mbelanger0/nixie-tube-clock/Eclectronics/3dshapes/DFN1006-2.stp

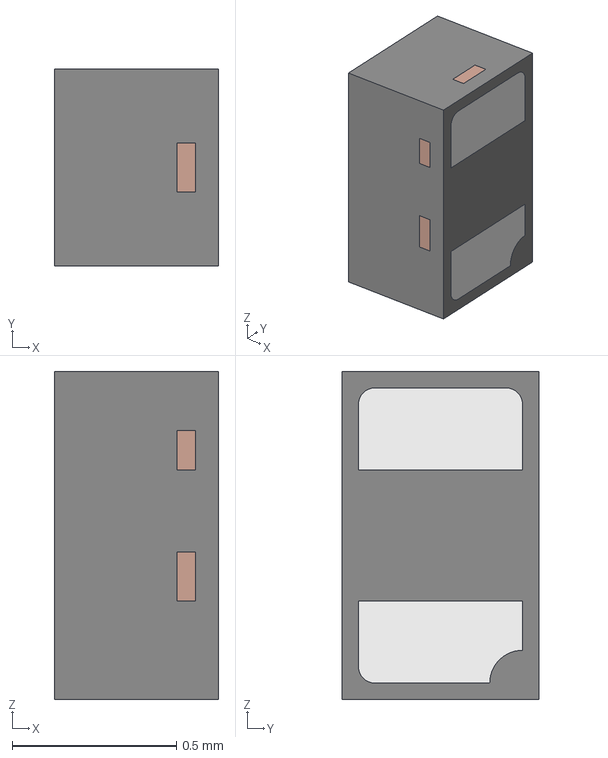
[picture p2: CAD file, 2026-03-12]
Eclectronics/3dshapes/DFN1006-2.stp
0.5 x 0.6 x 1.00 mm
LDF
