mbelanger0/nixie-tube-clock/eclectronics_nixie_3dmodels/c-1825027-8-g-3d.stp

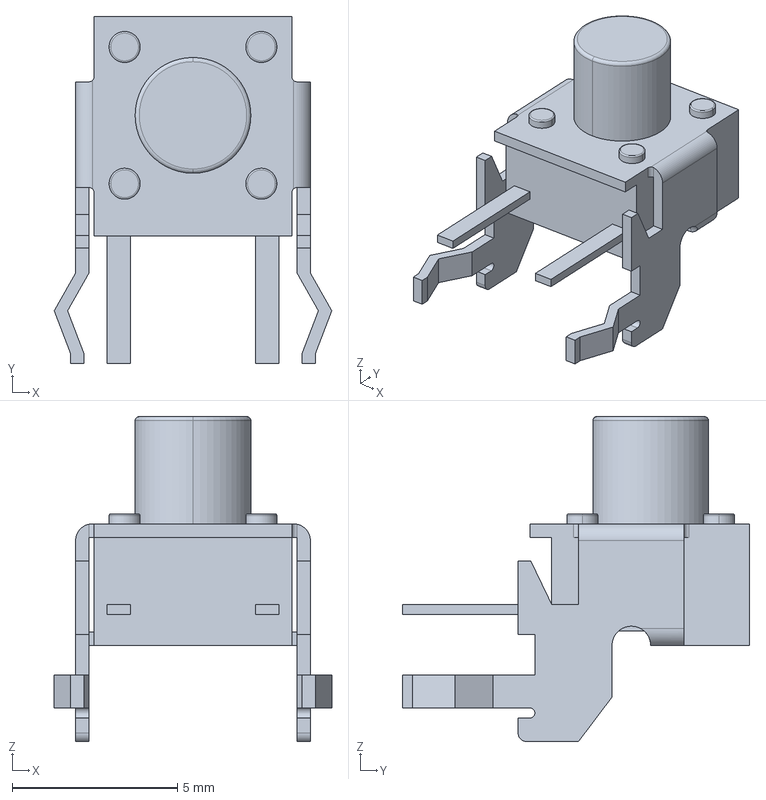
[picture p3: CAD file, 2026-04-13]
eclectronics_nixie_3dmodels/c-1825027-8-g-3d.stp
8.41 x 10.5 x 9.84 mm
