mbelanger0/nixie-tube-clock/Eclectronics/3dshapes/QFN-32_5x5.stp

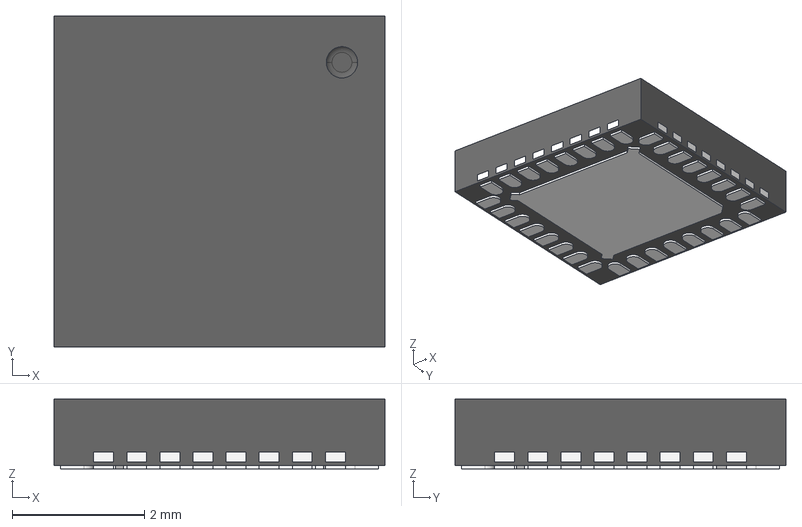
[picture p4: CAD file, 2026-03-12]
Eclectronics/3dshapes/QFN-32_5x5.stp
5.00 x 5.00 x 1.05 mm
