mbelanger0/nixie-tube-clock/eclectronics_nixie_3dmodels/Download_WE-PD_1210_STP+%28rev1%29.stp

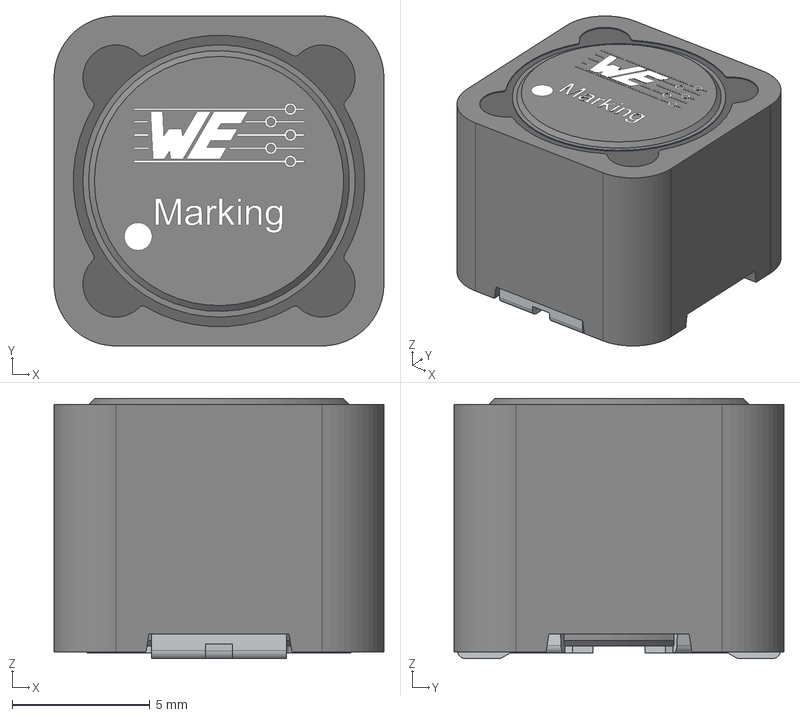
[picture p5: CAD file, 2026-04-06]
eclectronics_nixie_3dmodels/Download_WE-PD_1210_STP+%28rev1%29.stp
12.0 x 12.0 x 9.46 mm
Core
ShieldRing
Glue
Leadframe
