mbelanger0/nixie-tube-clock/Eclectronics/3dshapes/WS2812_RGB_LED_updated.stp

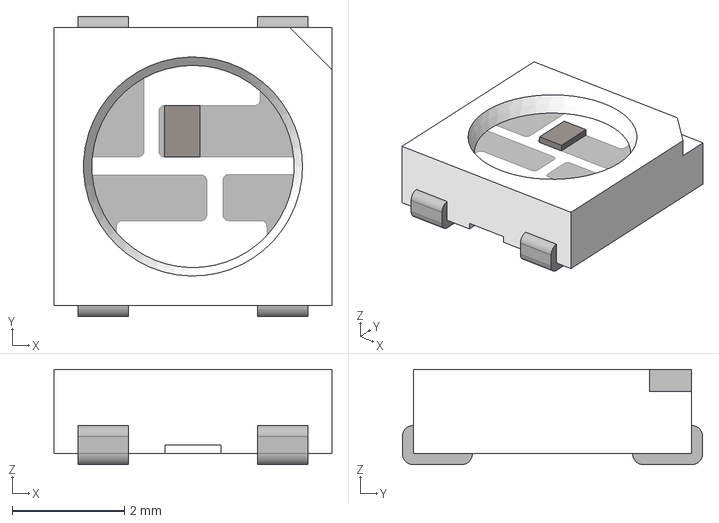
[picture p6: CAD file, 2026-03-12]
Eclectronics/3dshapes/WS2812_RGB_LED_updated.stp
4.95 x 5.35 x 1.70 mm
