mbelanger0/nixie-tube-clock/eclectronics_nixie_3dmodels/UCC3803DTR.stp

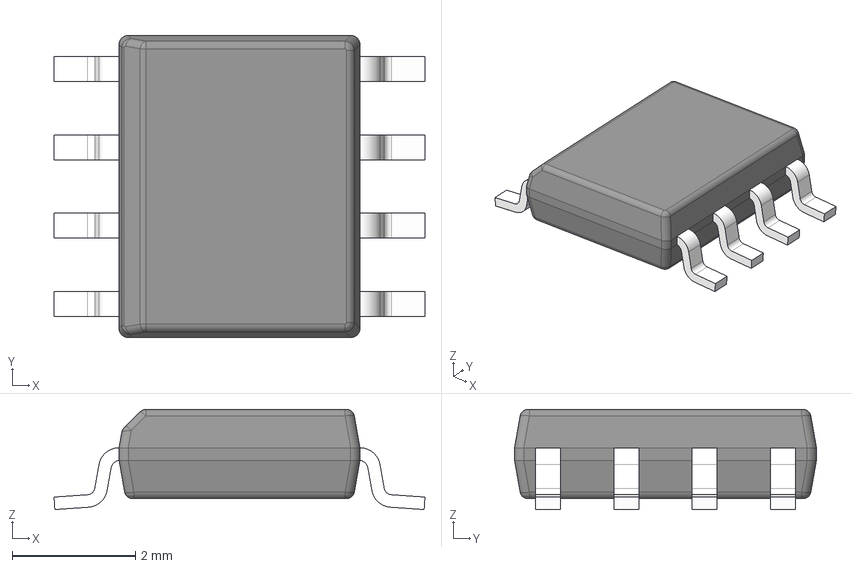
[picture p7: CAD file, 2026-04-02]
eclectronics_nixie_3dmodels/UCC3803DTR.stp
6.02 x 4.90 x 1.63 mm
BODY-SO
LEAD-D0008A x 8
