mbelanger0/nixie-tube-clock/Eclectronics/3dshapes/UFQFPN48.stp

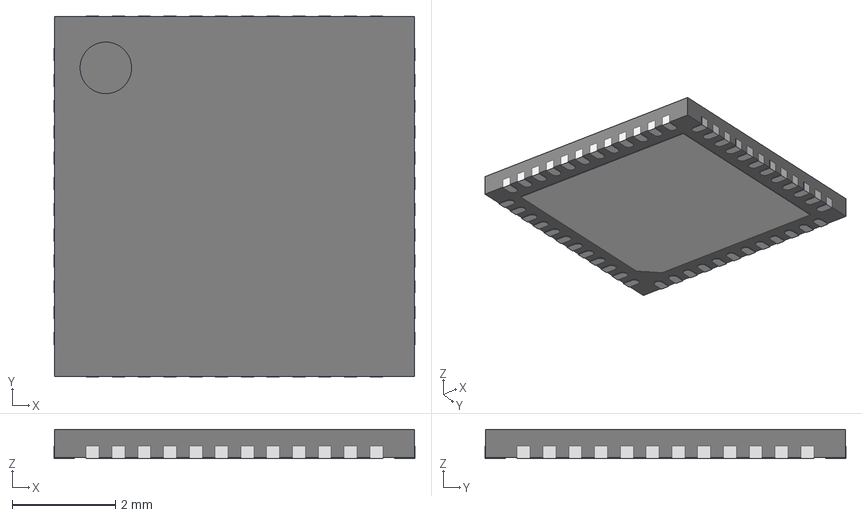
[picture p8: CAD file, 2026-03-12]
Eclectronics/3dshapes/UFQFPN48.stp
7.00 x 7.00 x 0.57 mm
