mbelanger0/nixie-tube-clock/Eclectronics/3dshapes/Analog_Devices_Inc_-_ADXL362BCCZ.step

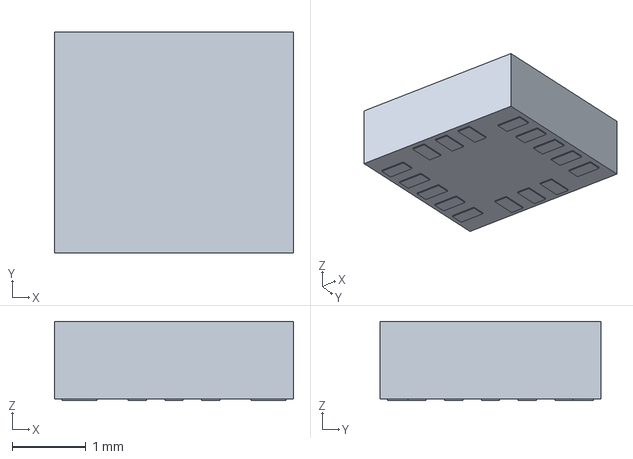
[picture p9: CAD file, 2026-03-12]
Eclectronics/3dshapes/Analog_Devices_Inc_-_ADXL362BCCZ.step
3.25 x 3.00 x 1.08 mm
