mbelanger0/nixie-tube-clock/eclectronics_nixie_3dmodels/QFP44_10x10MC_MCH.step

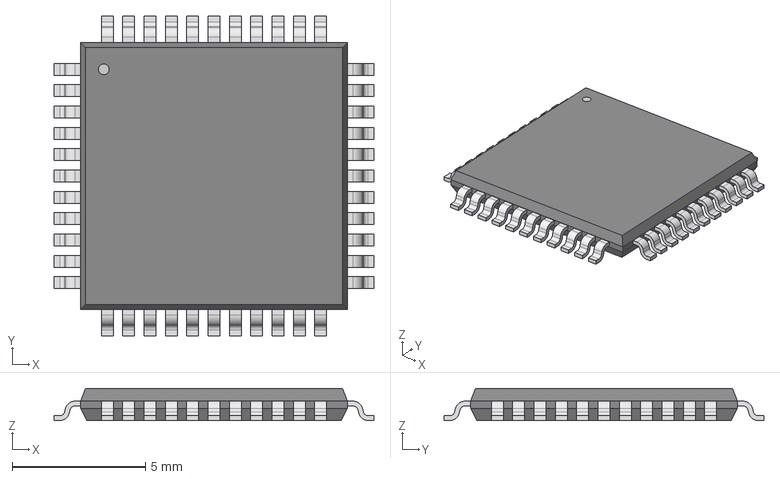
[picture p10: CAD file, 2026-03-23]
eclectronics_nixie_3dmodels/QFP44_10x10MC_MCH.step
12.0 x 12.0 x 1.20 mm
