mbelanger0/nixie-tube-clock/Eclectronics/3dshapes/TL3301NFxxxxJ.stp

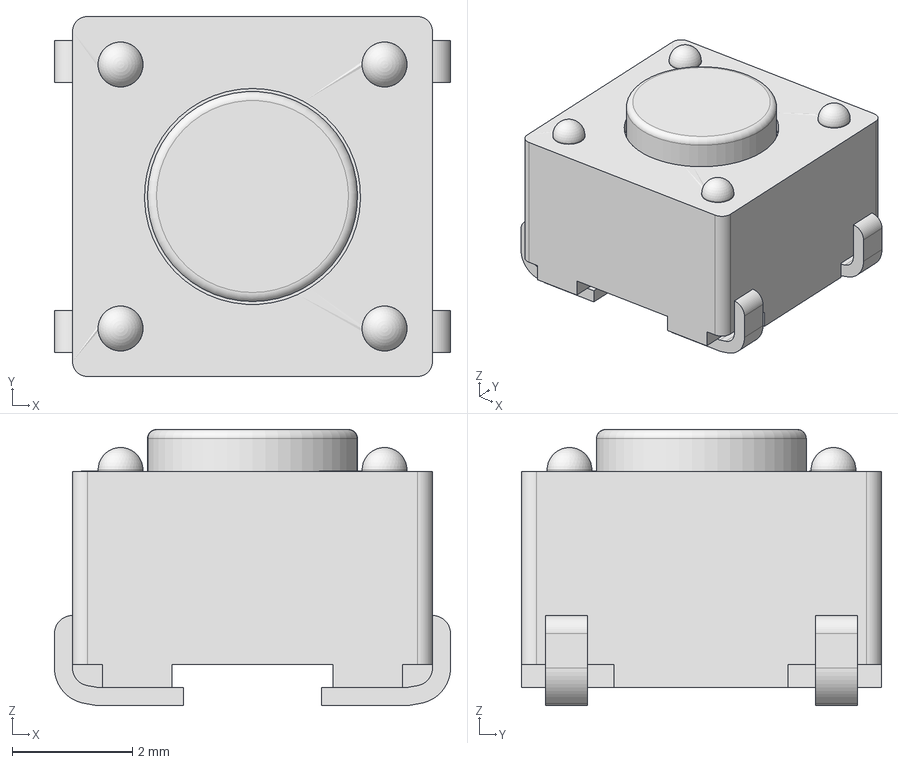
[picture p11: CAD file, 2026-03-12]
Eclectronics/3dshapes/TL3301NFxxxxJ.stp
6.60 x 6.00 x 4.60 mm
