mbelanger0/nixie-tube-clock/Eclectronics/3dshapes/CUI_DEVICES_PJ-202A.step

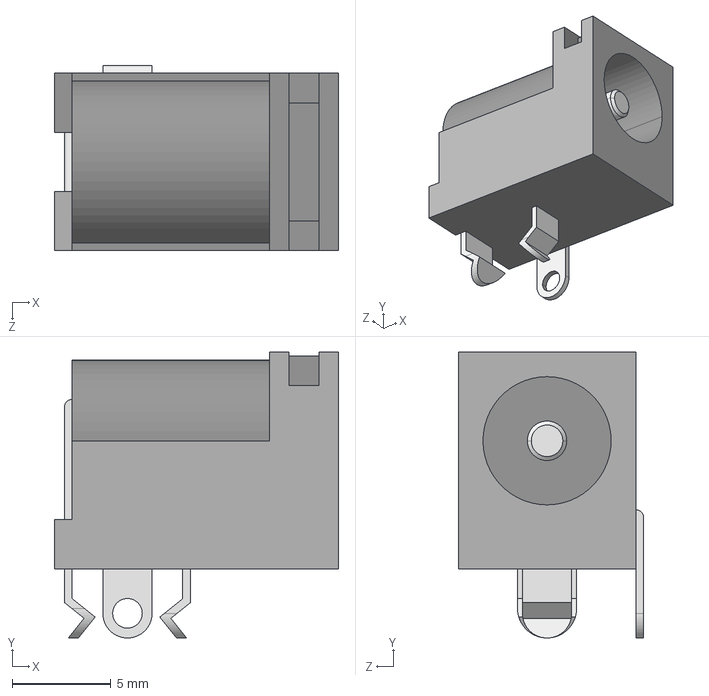
[picture p12: CAD file, 2026-03-12]
Eclectronics/3dshapes/CUI_DEVICES_PJ-202A.step
14.4 x 14.5 x 9.40 mm
