mbelanger0/nixie-tube-clock/Eclectronics/3dshapes/CUI_SDS-50J.step

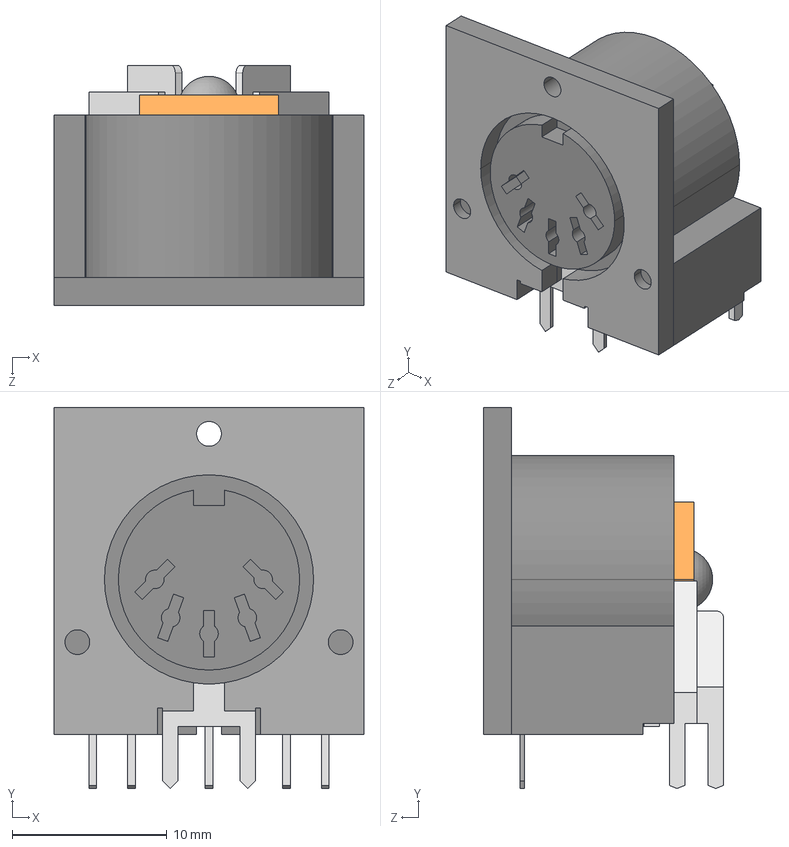
[picture p13: CAD file, 2026-03-12]
Eclectronics/3dshapes/CUI_SDS-50J.step
20.0 x 24.6 x 15.5 mm
