mbelanger0/nixie-tube-clock/Eclectronics/3dshapes/DFN8_3x3_0.65.step

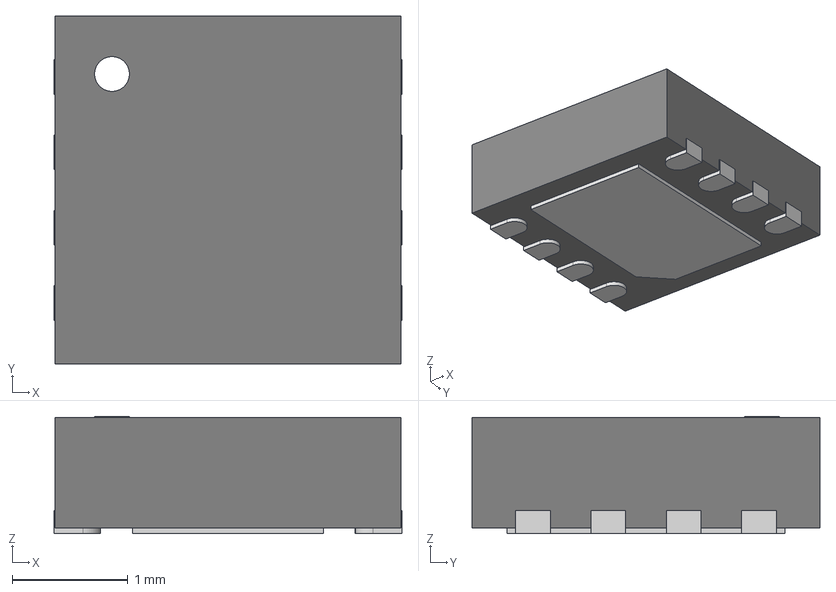
[picture p14: CAD file, 2026-03-12]
Eclectronics/3dshapes/DFN8_3x3_0.65.step
3.00 x 3.00 x 1.01 mm
