mbelanger0/nixie-tube-clock/Eclectronics/3dshapes/RP2350A-QFN60.step

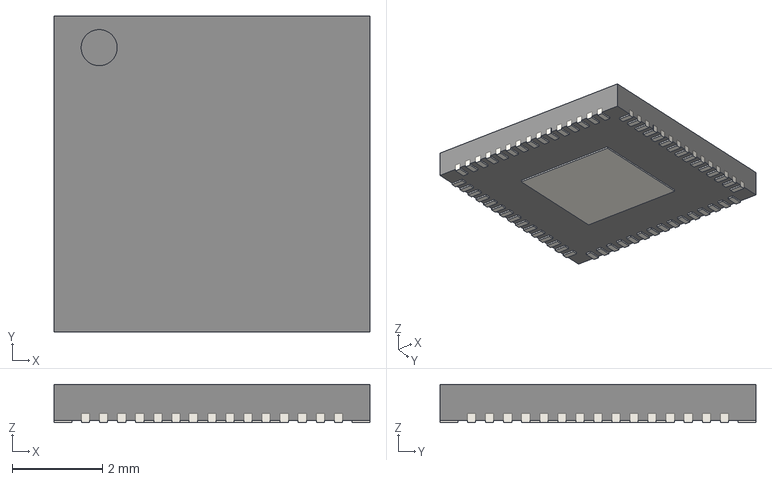
[picture p15: CAD file, 2026-03-12]
Eclectronics/3dshapes/RP2350A-QFN60.step
7.00 x 7.00 x 0.85 mm
