mbelanger0/nixie-tube-clock/Eclectronics/3dshapes/BarrelJack.STEP

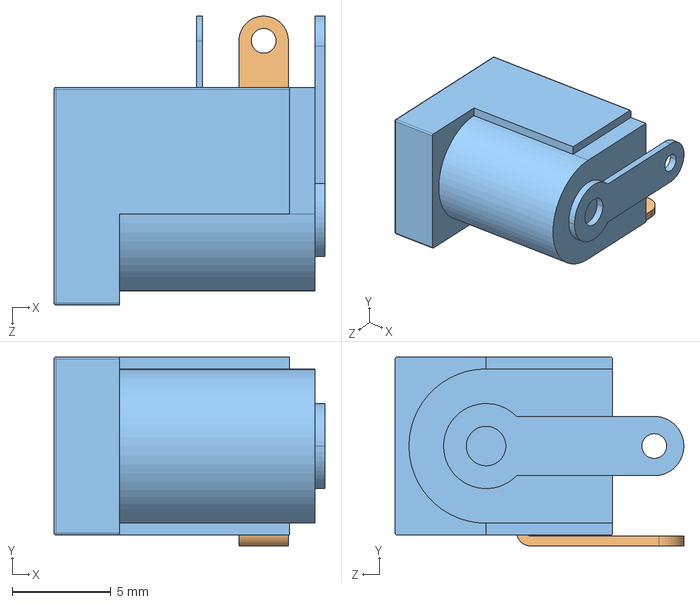
[picture p16: CAD file, 2026-03-12]
Eclectronics/3dshapes/BarrelJack.STEP
13.7 x 9.55 x 14.6 mm
