mbelanger0/nixie-tube-clock/Eclectronics/3dshapes/WSON8-6x5.STEP

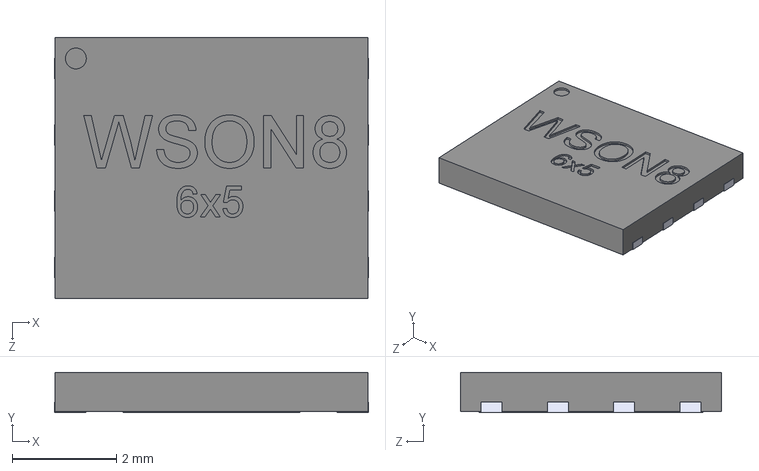
[picture p17: CAD file, 2026-03-12]
Eclectronics/3dshapes/WSON8-6x5.STEP
6.02 x 0.77 x 5.00 mm
