mbelanger0/nixie-tube-clock/Eclectronics/3dshapes/RP2040_QFN_PACKAGE.STEP

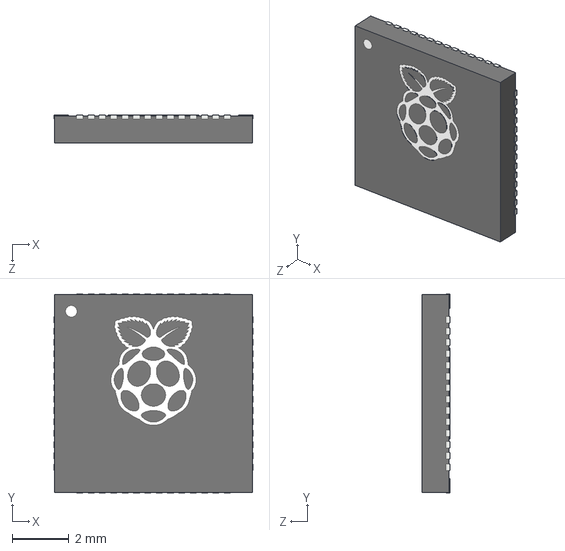
[picture p18: CAD file, 2026-03-12]
Eclectronics/3dshapes/RP2040_QFN_PACKAGE.STEP
7.02 x 7.02 x 1.00 mm
