mbelanger0/nixie-tube-clock/Eclectronics/3dshapes/ABM10.STP

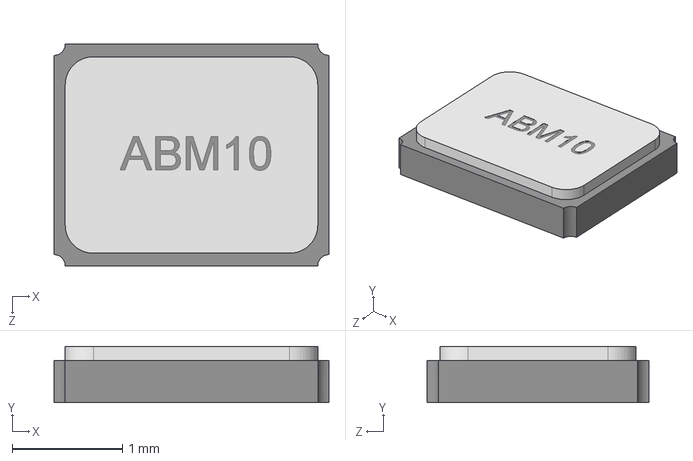
[picture p19: CAD file, 2026-03-12]
Eclectronics/3dshapes/ABM10.STP
2.49 x 0.508 x 2.01 mm
