mbelanger0/nixie-tube-clock/Eclectronics/3dshapes/EEEFTH101XAL.step

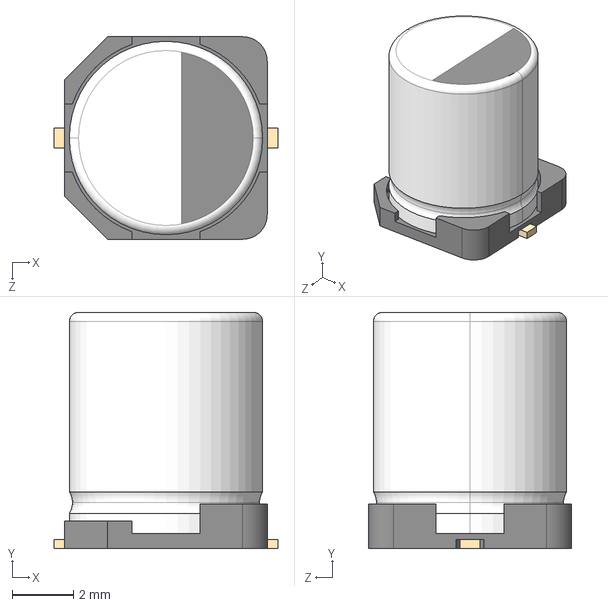
[picture p20: CAD file, 2026-03-12]
Eclectronics/3dshapes/EEEFTH101XAL.step
7.30 x 7.70 x 6.60 mm
