mbelanger0/nixie-tube-clock/Eclectronics/3dshapes/IN-S85TATRGB.stp

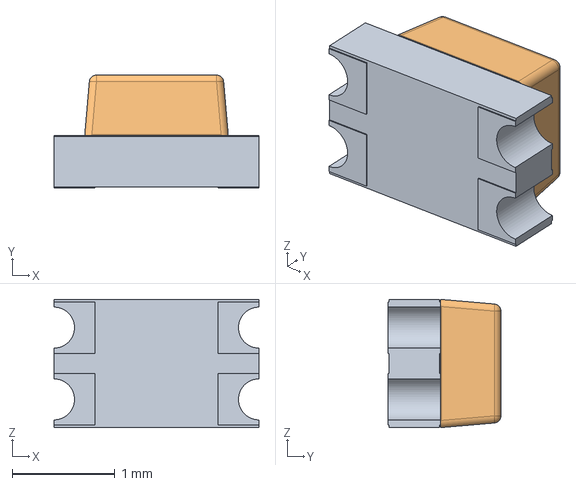
[picture p22: CAD file, 2026-03-12]
Eclectronics/3dshapes/IN-S85TATRGB.stp
2.00 x 1.10 x 1.25 mm
