mbelanger0/nixie-tube-clock/Eclectronics/3dshapes/TL3301AFxxxxJ.stp

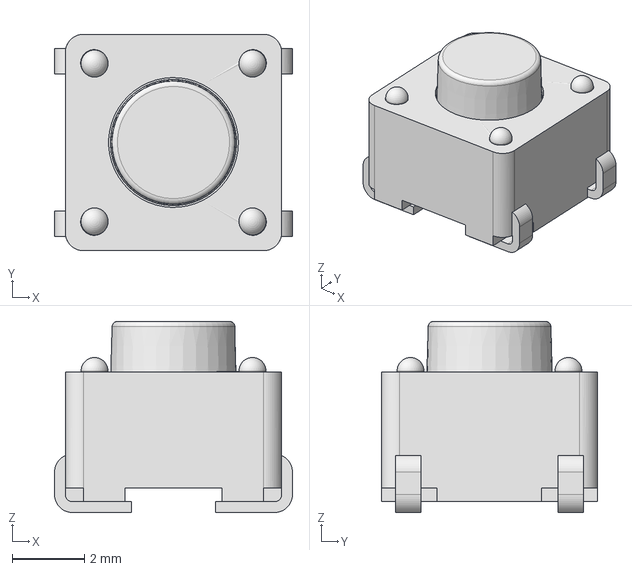
[picture p23: CAD file, 2026-03-12]
Eclectronics/3dshapes/TL3301AFxxxxJ.stp
6.60 x 6.00 x 5.30 mm
