mbelanger0/nixie-tube-clock/Eclectronics/3dshapes/219-3M.STEP

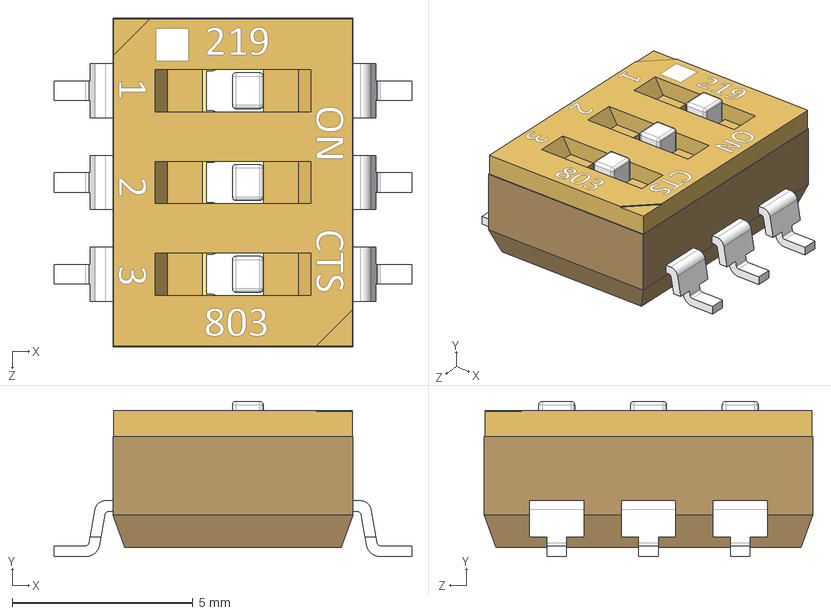
[picture p24: CAD file, 2026-03-12]
Eclectronics/3dshapes/219-3M.STEP
9.91 x 4.30 x 9.10 mm
