mbelanger0/nixie-tube-clock/Eclectronics/3dshapes/KXT321LHS.stp

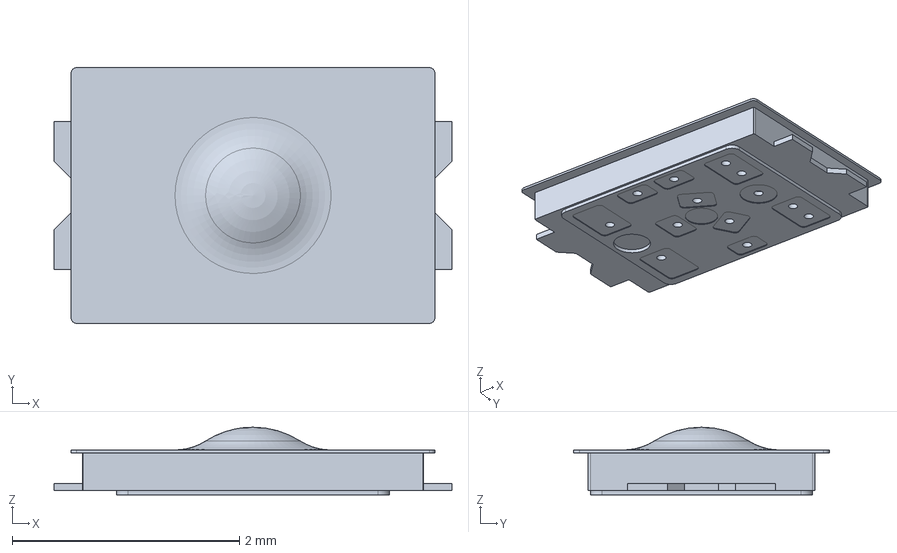
[picture p25: CAD file, 2026-03-12]
Eclectronics/3dshapes/KXT321LHS.stp
3.50 x 2.25 x 0.595 mm
