mbelanger0/nixie-tube-clock/Eclectronics/3dshapes/usb4216-03-a.stp

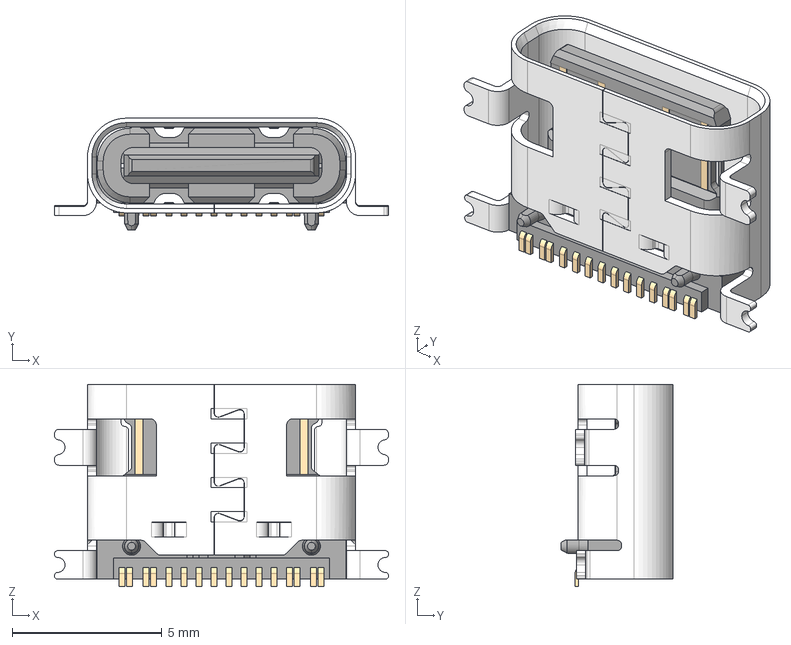
[picture p26: CAD file, 2026-03-12]
Eclectronics/3dshapes/usb4216-03-a.stp
11.1 x 3.73 x 6.75 mm
