mbelanger0/nixie-tube-clock/Eclectronics/3dshapes/AOTA-B201610S3R3-101-T.stp

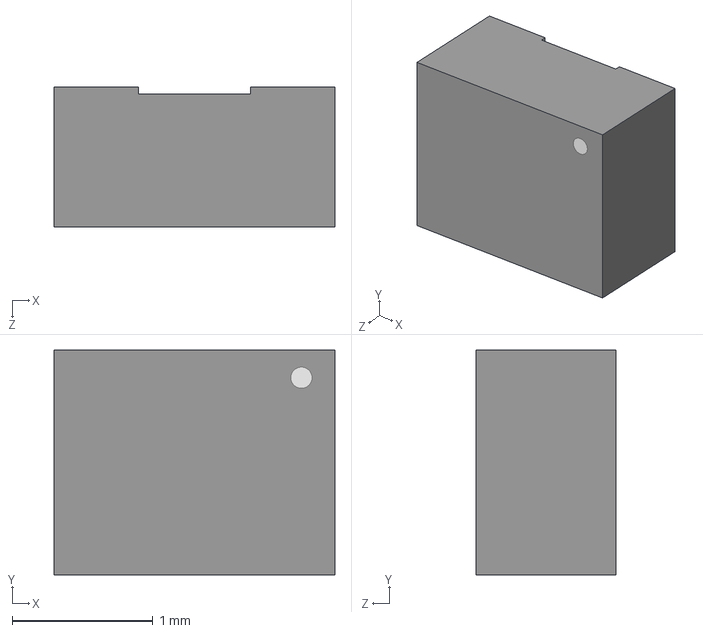
[picture p27: CAD file, 2026-03-12]
Eclectronics/3dshapes/AOTA-B201610S3R3-101-T.stp
2.00 x 1.60 x 1.00 mm
