mbelanger0/nixie-tube-clock/Eclectronics/3dshapes/WS2812-2020.STEP

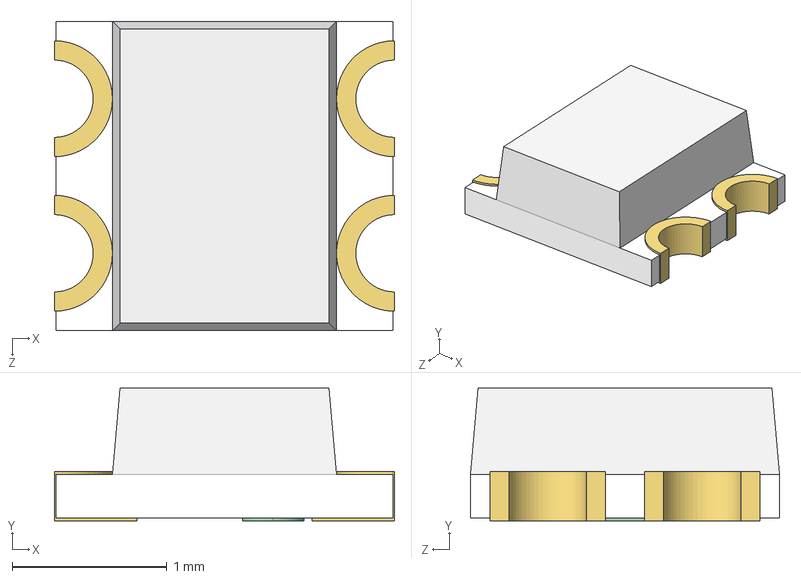
[picture p28: CAD file, 2026-03-12]
Eclectronics/3dshapes/WS2812-2020.STEP
2.20 x 0.86 x 2.00 mm
