mbelanger0/nixie-tube-clock/Eclectronics/3dshapes/USB4505-03-0-A_REVA.step

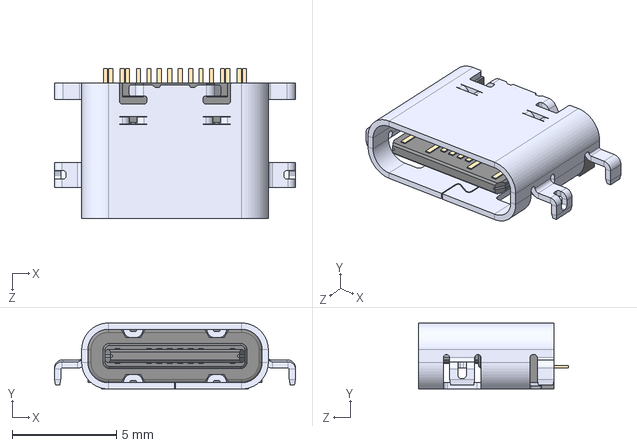
[picture p29: CAD file, 2026-03-12]
Eclectronics/3dshapes/USB4505-03-0-A_REVA.step
11.5 x 3.16 x 7.20 mm
