mbelanger0/nixie-tube-clock/Eclectronics/3dshapes/B4B-XH-A.step

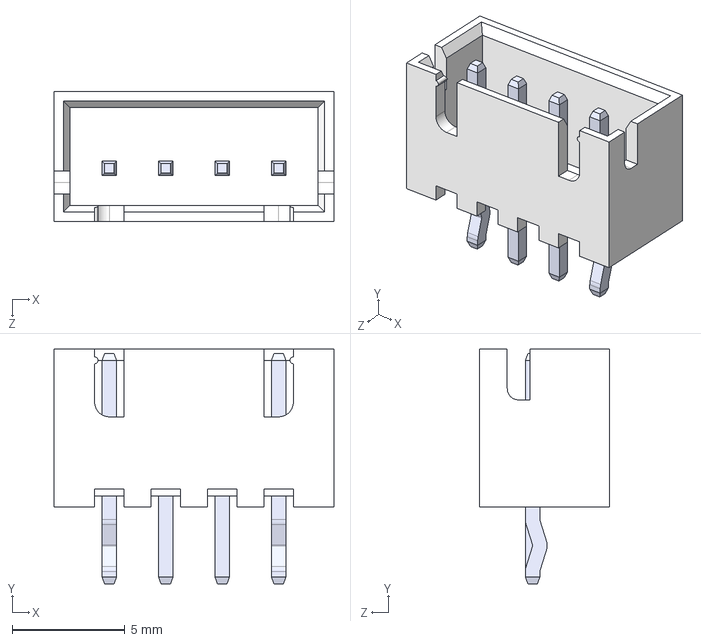
[picture p30: CAD file, 2026-03-12]
Eclectronics/3dshapes/B4B-XH-A.step
12.4 x 10.4 x 5.75 mm
