mbelanger0/nixie-tube-clock/Eclectronics/3dshapes/RTE0020A.stp

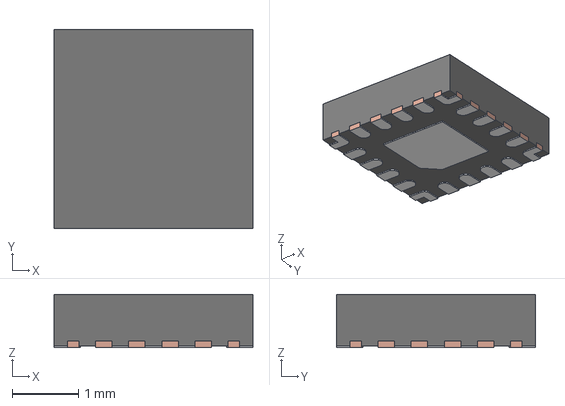
[picture p31: CAD file, 2026-03-12]
Eclectronics/3dshapes/RTE0020A.stp
3.00 x 3.00 x 0.8 mm
FRAME
