mbelanger0/nixie-tube-clock/Eclectronics/3dshapes/ABM10-27.000MHZ-E20-T.step

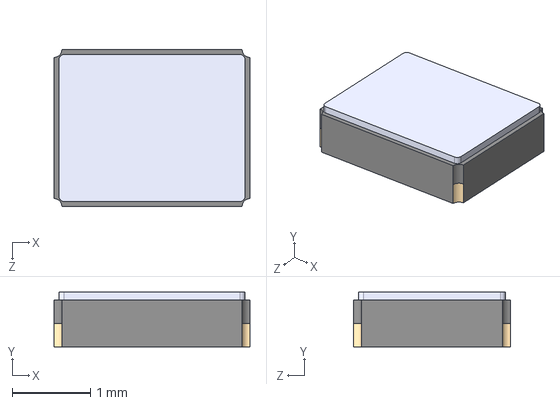
[picture p32: CAD file, 2026-03-12]
Eclectronics/3dshapes/ABM10-27.000MHZ-E20-T.step
2.50 x 0.7 x 2.00 mm
