mbelanger0/nixie-tube-clock/Eclectronics/3dshapes/STP_831056289_rev1.stp

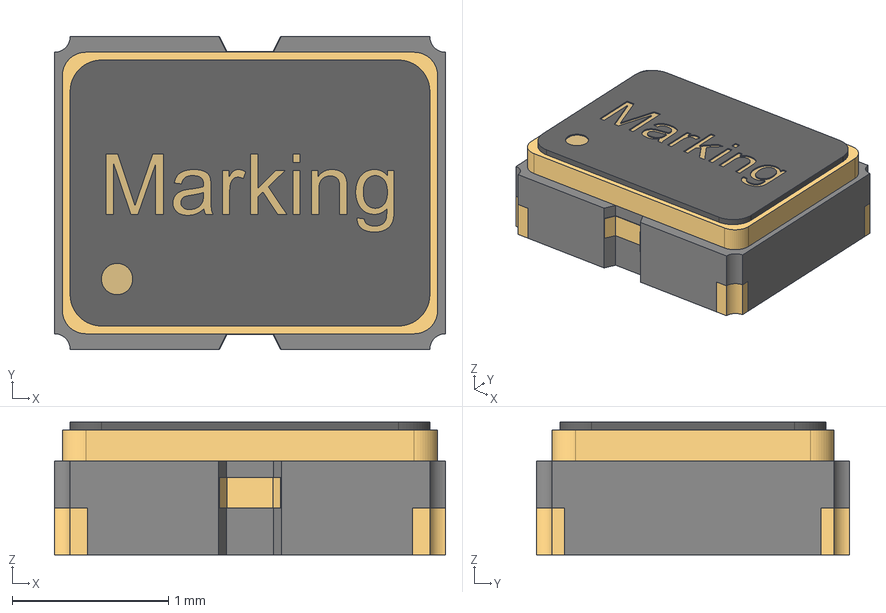
[picture p33: CAD file, 2026-03-12]
Eclectronics/3dshapes/STP_831056289_rev1.stp
2.50 x 2.00 x 0.85 mm
Pins
Cover
