mbelanger0/nixie-tube-clock/Eclectronics/3dshapes/CSTNE.step

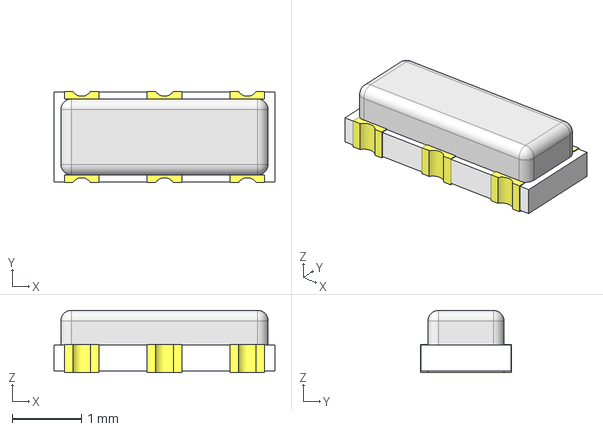
[picture p34: CAD file, 2026-03-12]
Eclectronics/3dshapes/CSTNE.step
3.20 x 1.32 x 0.9 mm
