mbelanger0/nixie-tube-clock/Eclectronics/3dshapes/S4B-PH-SM4-TB.stp

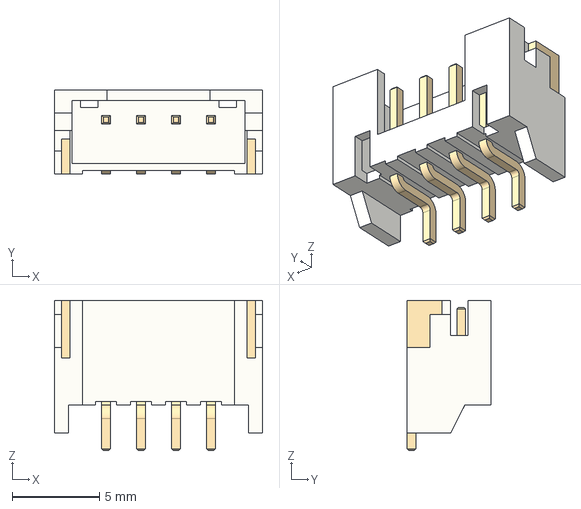
[picture p35: CAD file, 2026-03-12]
Eclectronics/3dshapes/S4B-PH-SM4-TB.stp
11.9 x 4.80 x 8.60 mm
