mbelanger0/nixie-tube-clock/Eclectronics/3dshapes/PA5003.182NLT.step

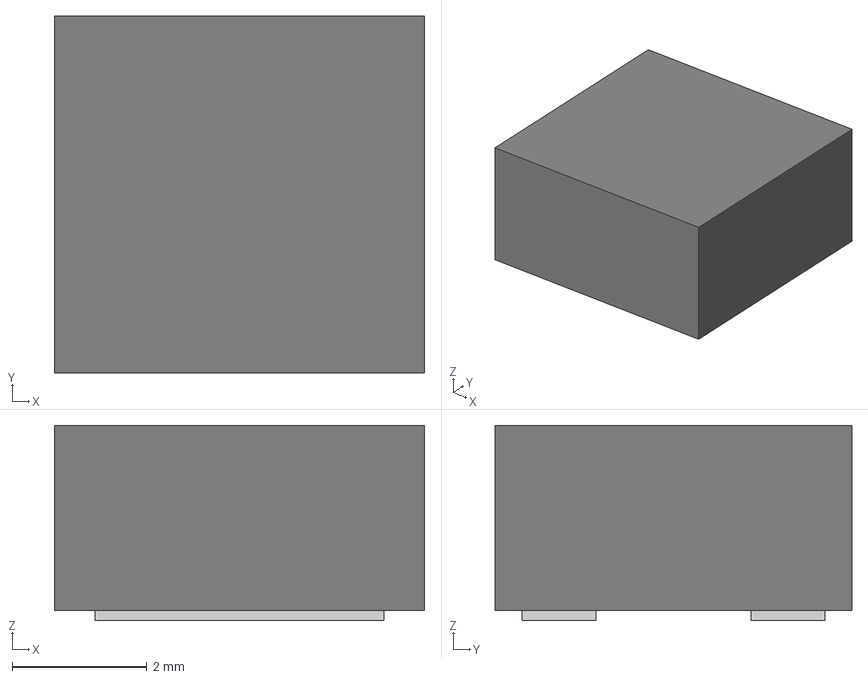
[picture p36: CAD file, 2026-03-12]
Eclectronics/3dshapes/PA5003.182NLT.step
5.50 x 5.30 x 2.90 mm
