mbelanger0/nixie-tube-clock/Eclectronics/3dshapes/RNR0011A.stp

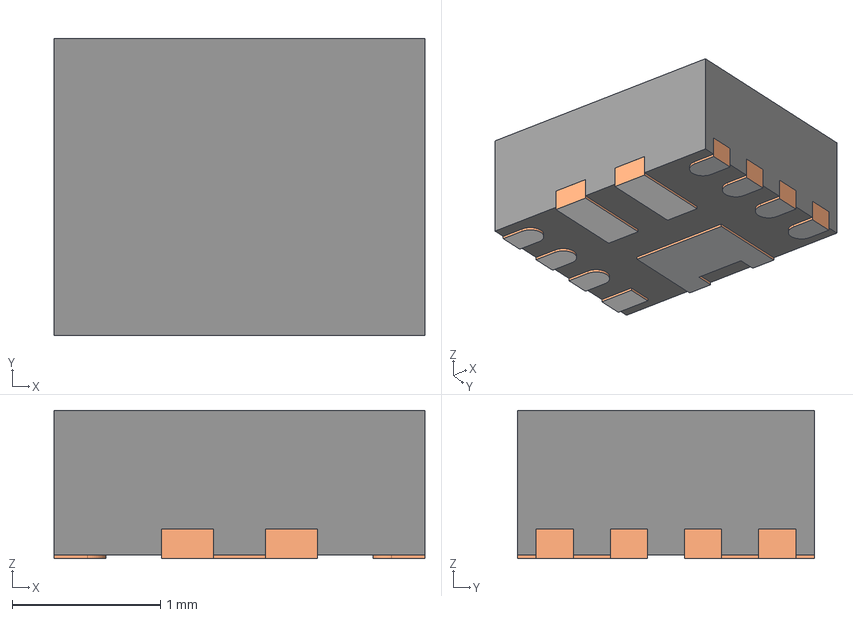
[picture p37: CAD file, 2026-03-12]
Eclectronics/3dshapes/RNR0011A.stp
2.50 x 2.00 x 1.00 mm
FRAME-RNR0011A
BODY-QFN
PIN1-ID
