mbelanger0/nixie-tube-clock/Eclectronics/3dshapes/ABS06-107.STP

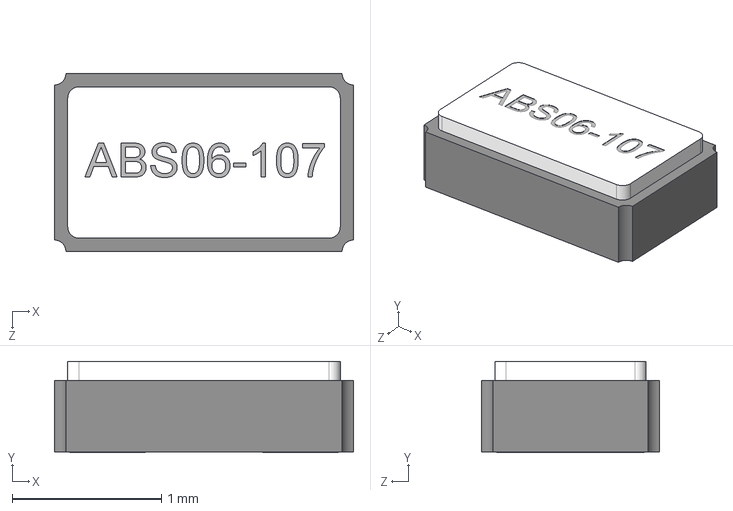
[picture p38: CAD file, 2026-03-12]
Eclectronics/3dshapes/ABS06-107.STP
2.01 x 0.612 x 1.19 mm
