mbelanger0/nixie-tube-clock/Eclectronics/3dshapes/SJ-3524-SMT-TR-BE.step

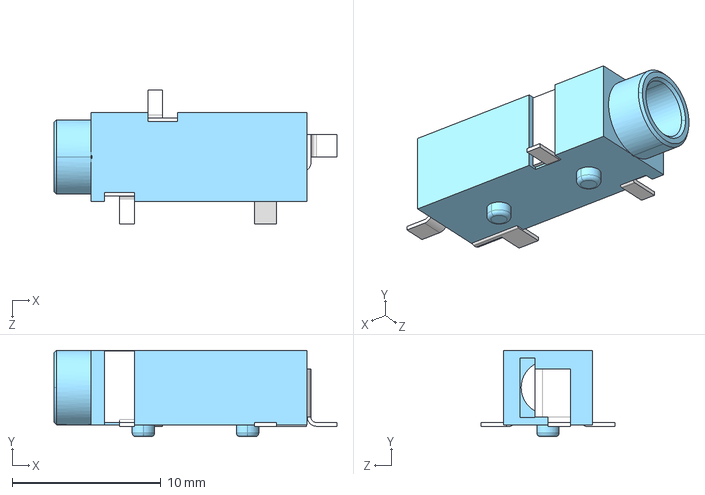
[picture p39: CAD file, 2026-03-12]
Eclectronics/3dshapes/SJ-3524-SMT-TR-BE.step
19.0 x 5.80 x 9.00 mm
