mbelanger0/nixie-tube-clock/Eclectronics/3dshapes/3382g-001-xxx.stp

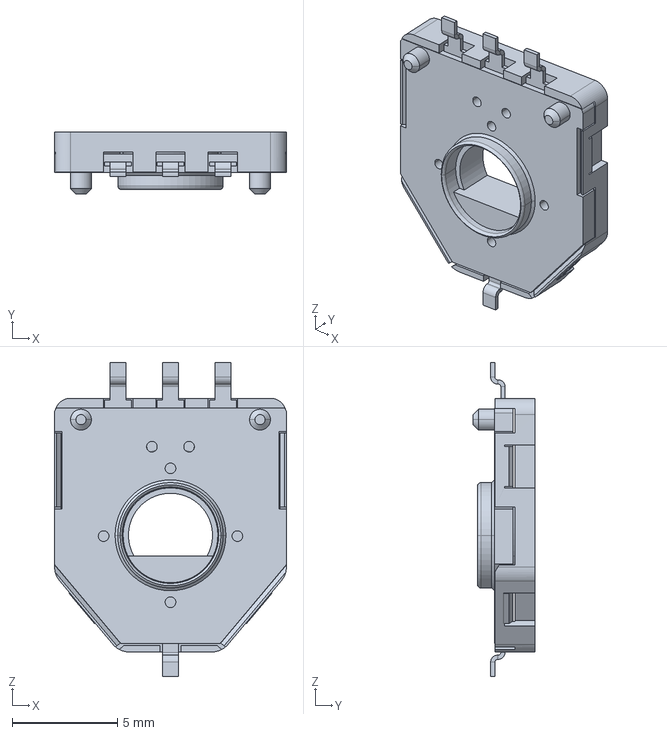
[picture p40: CAD file, 2026-03-12]
Eclectronics/3dshapes/3382g-001-xxx.stp
11.0 x 2.95 x 14.9 mm
