mbelanger0/nixie-tube-clock/Eclectronics/3dshapes/USB4105-GF-A.step

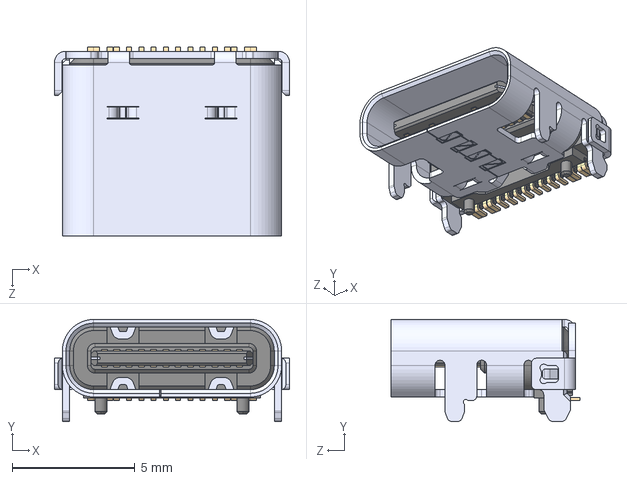
[picture p41: CAD file, 2026-03-12]
Eclectronics/3dshapes/USB4105-GF-A.step
9.58 x 4.16 x 7.71 mm
