mbelanger0/nixie-tube-clock/(list of files, cad)

Other CAD files:
Eclectronics/3dshapes/1725656.stp
Eclectronics/3dshapes/5442565.stp
eclectronics_nixie_3dmodels/TPS61041DBVR.stp
