mbelanger0/nixie-tube-clock/nixie-tube-clock.kicad_pcb

## KiCad design nixie-tube-clock.kicad_pcb (2026-04-16)

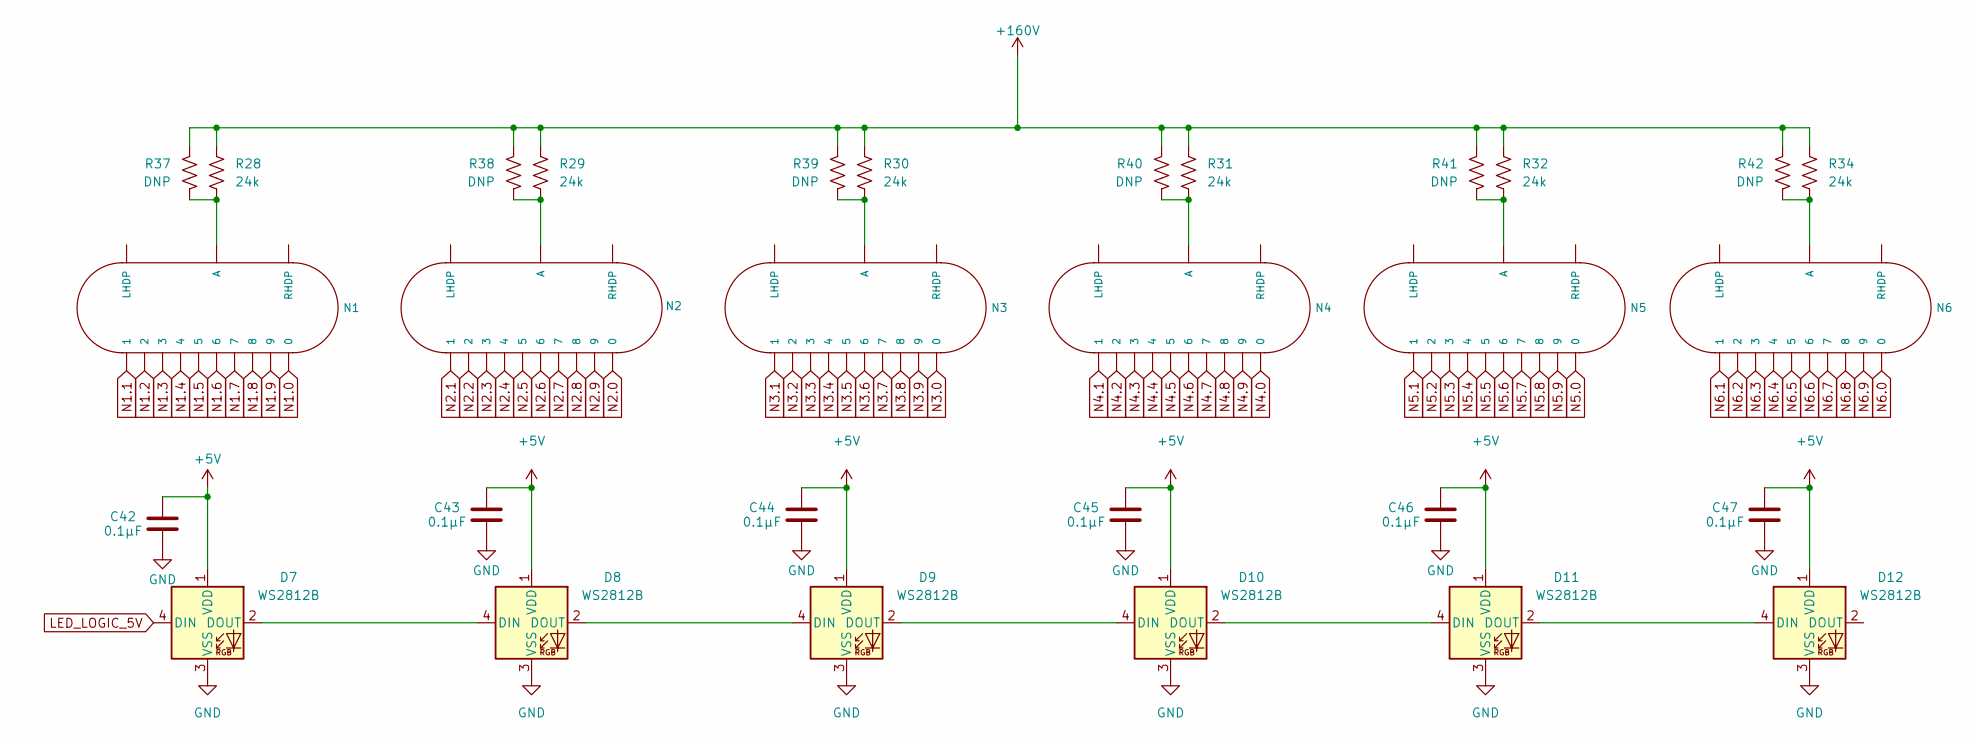
[picture p42: schematic nixie_tubes.kicad_sch]

Parts:
C42, C43, C44, C45, C46, C47: 0.1µF; C_0603_1608Metric; DigikeyPN 1276-1033-1-ND
D7, D8, D9, D10, D11, D12: WS2812B; LED_WS2812B_PLCC4_5.0x5.0mm_P3.2mm; DigikeyPN 1568-16347CT-ND
N1, N2, N3, N4, N5, N6: IN-14; nixies-us-IN-14
R28, R29, R30, R31, R32, R34: 24k; R_2512_6332Metric; DigikeyPN RMCF2512JT24K0CT-ND
R37, R38, R39, R40, R41, R42: DNP; R_Axial_DIN0207_L6.3mm_D2.5mm_P10.16mm_Horizontal; MPN PR01000102402JR500; DigikeyPN 56-PR01000102402JR500CT-ND

Connections:
+5V: C42.1, C43.1, C44.1, C45.1, C46.1, C47.1, D7.1 (VDD), D8.1 (VDD), D9.1 (VDD), D10.1 (VDD), D11.1 (VDD), D12.1 (VDD); also elsewhere on the board
+160V: R28.1, R29.1, R30.1, R31.1, R32.1, R34.1, R37.1, R38.1, R39.1, R40.1, R41.1, R42.1; also elsewhere on the board
LED_LOGIC_5V: D7.4 (DIN); also elsewhere on the board
N1.0: N1.0; also elsewhere on the board
N1.1: N1.1; also elsewhere on the board
N1.2: N1.2; also elsewhere on the board
N1.3: N1.3; also elsewhere on the board
N1.4: N1.4; also elsewhere on the board
N1.5: N1.5; also elsewhere on the board
N1.6: N1.6; also elsewhere on the board
N1.7: N1.7; also elsewhere on the board
N1.8: N1.8; also elsewhere on the board
N1.9: N1.9; also elsewhere on the board
N2.0: N2.0; also elsewhere on the board
N2.1: N2.1; also elsewhere on the board
N2.2: N2.2; also elsewhere on the board
N2.3: N2.3; also elsewhere on the board
N2.4: N2.4; also elsewhere on the board
N2.5: N2.5; also elsewhere on the board
N2.6: N2.6; also elsewhere on the board
N2.7: N2.7; also elsewhere on the board
N2.8: N2.8; also elsewhere on the board
N2.9: N2.9; also elsewhere on the board
N3.0: N3.0; also elsewhere on the board
N3.1: N3.1; also elsewhere on the board
N3.2: N3.2; also elsewhere on the board
N3.3: N3.3; also elsewhere on the board
N3.4: N3.4; also elsewhere on the board
N3.5: N3.5; also elsewhere on the board
N3.6: N3.6; also elsewhere on the board
N3.7: N3.7; also elsewhere on the board
N3.8: N3.8; also elsewhere on the board
N3.9: N3.9; also elsewhere on the board
N4.0: N4.0; also elsewhere on the board
N4.1: N4.1; also elsewhere on the board
N4.2: N4.2; also elsewhere on the board
N4.3: N4.3; also elsewhere on the board
N4.4: N4.4; also elsewhere on the board
N4.5: N4.5; also elsewhere on the board
N4.6: N4.6; also elsewhere on the board
N4.7: N4.7; also elsewhere on the board
N4.8: N4.8; also elsewhere on the board
N4.9: N4.9; also elsewhere on the board
N5.0: N5.0; also elsewhere on the board
N5.1: N5.1; also elsewhere on the board
N5.2: N5.2; also elsewhere on the board
N5.3: N5.3; also elsewhere on the board
N5.4: N5.4; also elsewhere on the board
N5.5: N5.5; also elsewhere on the board
N5.6: N5.6; also elsewhere on the board
N5.7: N5.7; also elsewhere on the board
N5.8: N5.8; also elsewhere on the board
N5.9: N5.9; also elsewhere on the board
N6.0: N6.0; also elsewhere on the board
N6.1: N6.1; also elsewhere on the board
N6.2: N6.2; also elsewhere on the board
N6.3: N6.3; also elsewhere on the board
N6.4: N6.4; also elsewhere on the board
N6.5: N6.5; also elsewhere on the board
N6.6: N6.6; also elsewhere on the board
N6.7: N6.7; also elsewhere on the board
N6.8: N6.8; also elsewhere on the board
N6.9: N6.9; also elsewhere on the board
unnamed: D7.2 (DOUT), D8.4 (DIN)
unnamed: D8.2 (DOUT), D9.4 (DIN)
unnamed: D9.2 (DOUT), D10.4 (DIN)
unnamed: D10.2 (DOUT), D11.4 (DIN)
unnamed: D11.2 (DOUT), D12.4 (DIN)
unnamed: N1.A, R28.2, R37.2
unnamed: N2.A, R29.2, R38.2
unnamed: N3.A, R30.2, R39.2
unnamed: N4.A, R31.2, R40.2
unnamed: N5.A, R32.2, R41.2
unnamed: N6.A, R34.2, R42.2

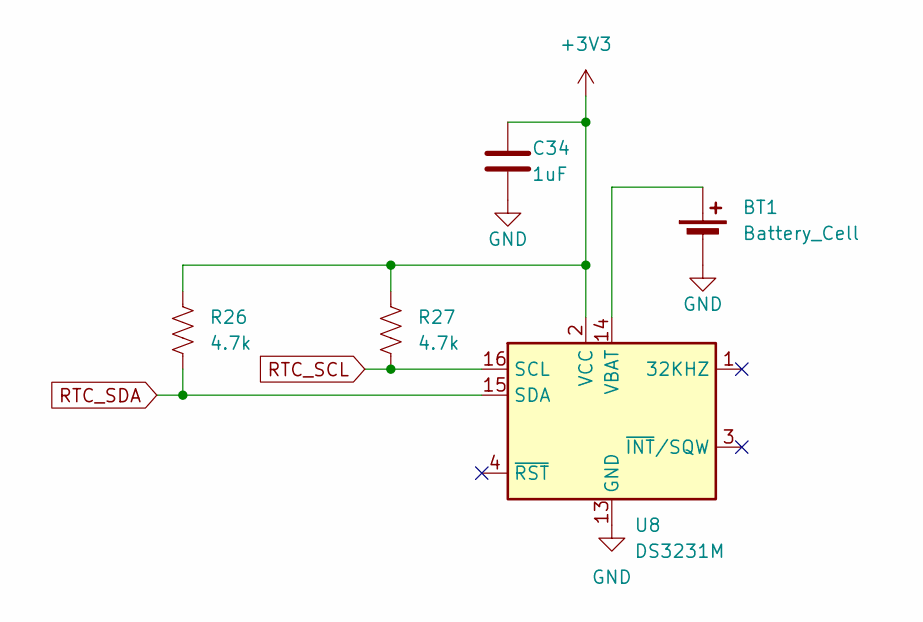
[picture p43: schematic real_time_clock.kicad_sch]

Parts:
BT1: Battery_Cell; BatteryHolder_Keystone_3034_1x20mm; MPN 3034; DigikeyPN 36-3034-ND
C34: 1uF; C_0603_1608Metric; DigikeyPN 1276-1184-1-ND
R26, R27: 4.7k; R_0603_1608Metric; DigikeyPN 311-4.70KHRCT-ND
U8: DS3231M; SOIC-16W_7.5x10.3mm_P1.27mm

Connections:
+3V3: C34.1, R26.1, R27.1, U8.2 (VCC); also elsewhere on the board
unnamed: BT1.1 (+), U8.14 (VBAT)
RTC_SCL: R27.2, U8.16 (SCL); also elsewhere on the board
RTC_SDA: R26.2, U8.15 (SDA); also elsewhere on the board

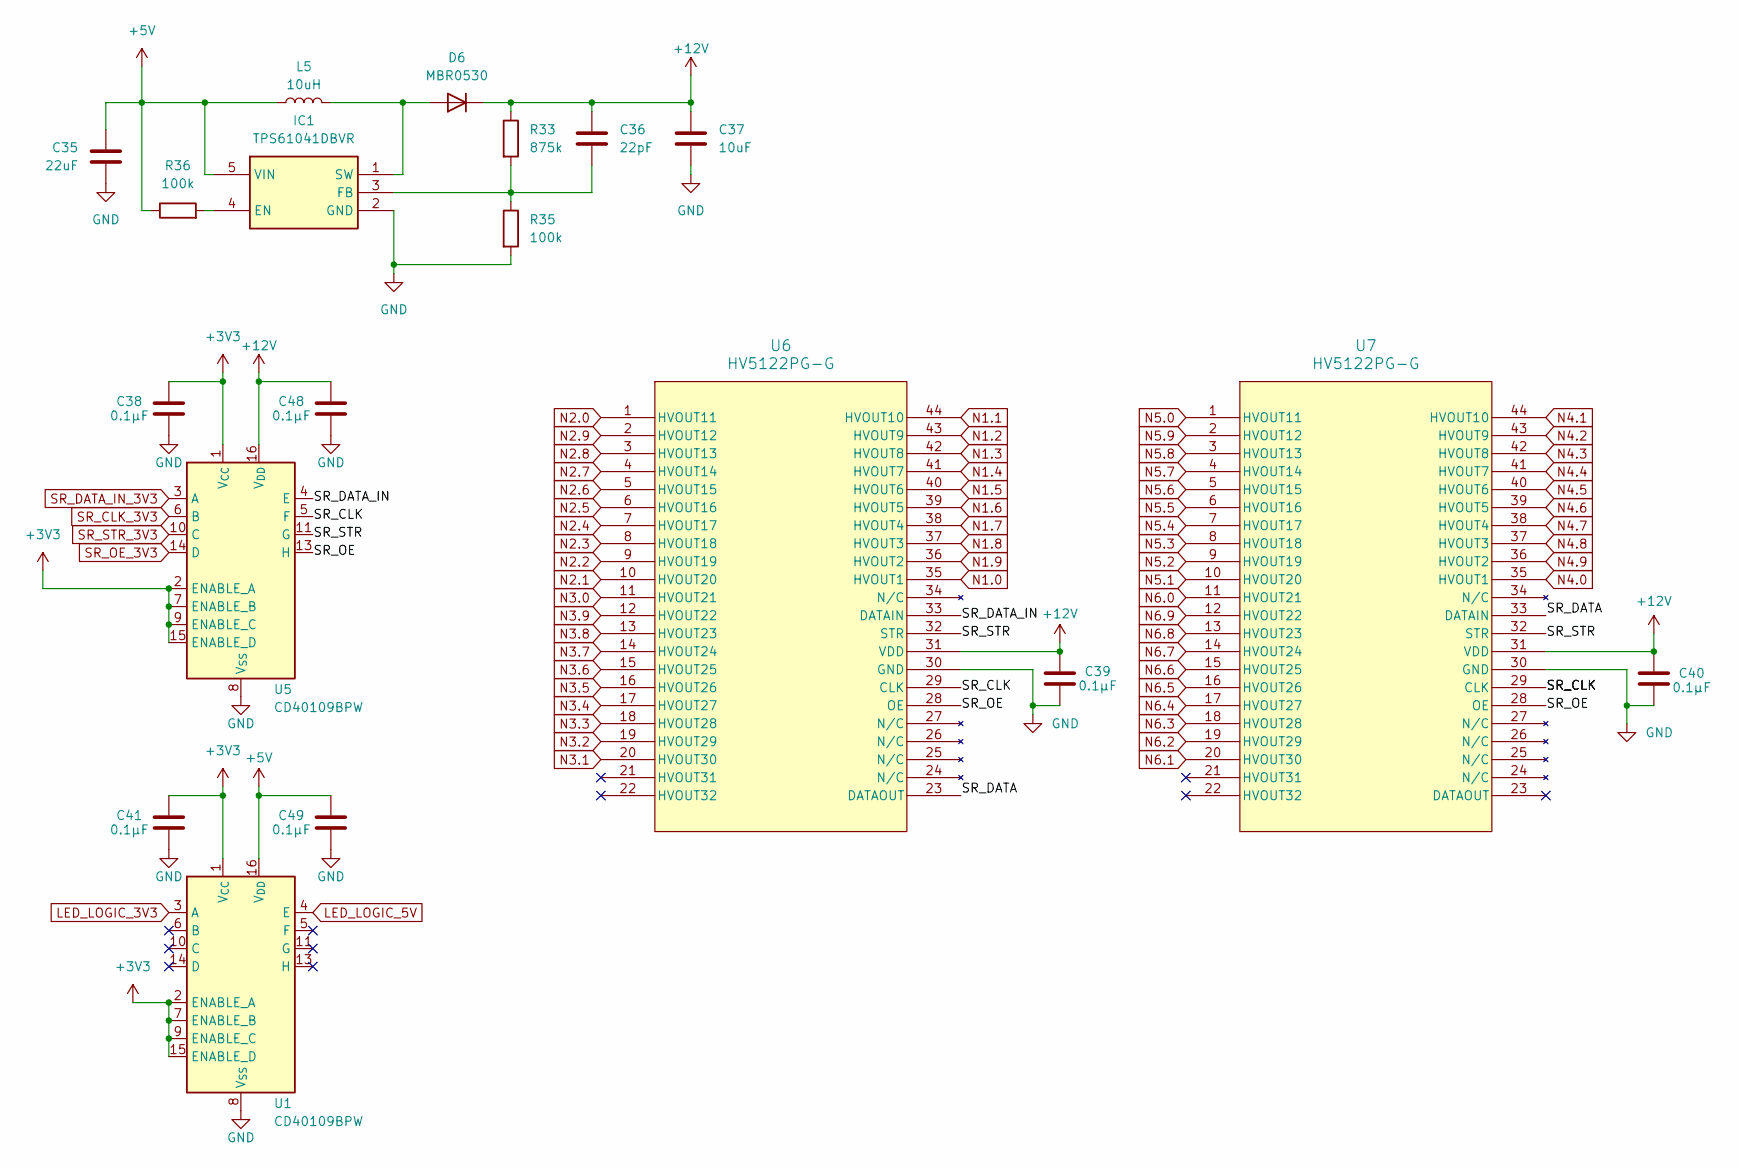
[picture p44: schematic nixie_tubes_driver.kicad_sch]

Parts:
C35: 22uF; C_0805_2012Metric; MPN CL21A226MQQNNNE; DigikeyPN 1276-1100-1-ND
C36: 22pF; C_0603_1608Metric; DigikeyPN 399-C0603C220J5GACTUCT-ND
C37: 10uF; C_1206_3216Metric; MPN CL31A106KAHNNNE; DigikeyPN 1276-1075-1-ND
C38, C39, C40, C41, C48, C49: 0.1µF; C_0603_1608Metric; DigikeyPN 1276-1033-1-ND
D6: MBR0530; D_SOD-123; MPN MBR0530; DigikeyPN 1655-MBR0530CT-ND
IC1: TPS61041DBVR; SOT95P280X145-5N; MPN TPS61041DBVR; DigikeyPN 296-12686-1-ND
L5: 10uH; L_1008_2520Metric; MPN 74479889310; DigikeyPN 732-74479889310CT-ND
R33: 875k; R_0805_2012Metric; DigikeyPN 2019-RN73H2ATTD8763F10CT-ND
R35, R36: 100k; R_0603_1608Metric; DigikeyPN 311-100KCRCT-ND
U1, U5: CD40109BPW; TSSOP-16_4.4x5mm_P0.65mm; DigikeyPN 296-32859-5-ND
U6, U7: HV5122PG-G; QFP44_10x10MC_MCH; MPN HV5122PG-G; LCSCPN C637042

Connections:
+3V3: C38.1, C41.1, U1.1 (V_{CC}), U1.2 (ENABLE_A), U1.7 (ENABLE_B), U1.9 (ENABLE_C), U1.15 (ENABLE_D), U5.1 (V_{CC}), U5.2 (ENABLE_A), U5.7 (ENABLE_B), U5.9 (ENABLE_C), U5.15 (ENABLE_D); also elsewhere on the board
+5V: C35.1, C49.1, IC1.5 (VIN), L5.1, R36.1, U1.16 (V_{DD}); also elsewhere on the board
+12V: C36.1, C37.1, C39.1, C40.1, C48.1, D6.1 (K), R33.1, U5.16 (V_{DD}), U6.31 (VDD), U7.31 (VDD)
/nixie_tubes_driver/SR_CLK: U5.5 (F), U6.29 (CLK), U7.29 (CLK)
/nixie_tubes_driver/SR_DATA: U6.23 (DATAOUT), U7.33 (DATAIN)
/nixie_tubes_driver/SR_DATA_IN: U5.4 (E), U6.33 (DATAIN)
/nixie_tubes_driver/SR_OE: U5.13 (H), U6.28 (OE), U7.28 (OE)
/nixie_tubes_driver/SR_STR: U5.11 (G), U6.32 (STR), U7.32 (STR)
LED_LOGIC_3V3: U1.3 (A); also elsewhere on the board
LED_LOGIC_5V: U1.4 (E); also elsewhere on the board
N1.0: U6.35 (HVOUT1); also elsewhere on the board
N1.1: U6.44 (HVOUT10); also elsewhere on the board
N1.2: U6.43 (HVOUT9); also elsewhere on the board
N1.3: U6.42 (HVOUT8); also elsewhere on the board
N1.4: U6.41 (HVOUT7); also elsewhere on the board
N1.5: U6.40 (HVOUT6); also elsewhere on the board
N1.6: U6.39 (HVOUT5); also elsewhere on the board
N1.7: U6.38 (HVOUT4); also elsewhere on the board
N1.8: U6.37 (HVOUT3); also elsewhere on the board
N1.9: U6.36 (HVOUT2); also elsewhere on the board
N2.0: U6.1 (HVOUT11); also elsewhere on the board
N2.1: U6.10 (HVOUT20); also elsewhere on the board
N2.2: U6.9 (HVOUT19); also elsewhere on the board
N2.3: U6.8 (HVOUT18); also elsewhere on the board
N2.4: U6.7 (HVOUT17); also elsewhere on the board
N2.5: U6.6 (HVOUT16); also elsewhere on the board
N2.6: U6.5 (HVOUT15); also elsewhere on the board
N2.7: U6.4 (HVOUT14); also elsewhere on the board
N2.8: U6.3 (HVOUT13); also elsewhere on the board
N2.9: U6.2 (HVOUT12); also elsewhere on the board
N3.0: U6.11 (HVOUT21); also elsewhere on the board
N3.1: U6.20 (HVOUT30); also elsewhere on the board
N3.2: U6.19 (HVOUT29); also elsewhere on the board
N3.3: U6.18 (HVOUT28); also elsewhere on the board
N3.4: U6.17 (HVOUT27); also elsewhere on the board
N3.5: U6.16 (HVOUT26); also elsewhere on the board
N3.6: U6.15 (HVOUT25); also elsewhere on the board
N3.7: U6.14 (HVOUT24); also elsewhere on the board
N3.8: U6.13 (HVOUT23); also elsewhere on the board
N3.9: U6.12 (HVOUT22); also elsewhere on the board
N4.0: U7.35 (HVOUT1); also elsewhere on the board
N4.1: U7.44 (HVOUT10); also elsewhere on the board
N4.2: U7.43 (HVOUT9); also elsewhere on the board
N4.3: U7.42 (HVOUT8); also elsewhere on the board
N4.4: U7.41 (HVOUT7); also elsewhere on the board
N4.5: U7.40 (HVOUT6); also elsewhere on the board
N4.6: U7.39 (HVOUT5); also elsewhere on the board
N4.7: U7.38 (HVOUT4); also elsewhere on the board
N4.8: U7.37 (HVOUT3); also elsewhere on the board
N4.9: U7.36 (HVOUT2); also elsewhere on the board
N5.0: U7.1 (HVOUT11); also elsewhere on the board
N5.1: U7.10 (HVOUT20); also elsewhere on the board
N5.2: U7.9 (HVOUT19); also elsewhere on the board
N5.3: U7.8 (HVOUT18); also elsewhere on the board
N5.4: U7.7 (HVOUT17); also elsewhere on the board
N5.5: U7.6 (HVOUT16); also elsewhere on the board
N5.6: U7.5 (HVOUT15); also elsewhere on the board
N5.7: U7.4 (HVOUT14); also elsewhere on the board
N5.8: U7.3 (HVOUT13); also elsewhere on the board
N5.9: U7.2 (HVOUT12); also elsewhere on the board
N6.0: U7.11 (HVOUT21); also elsewhere on the board
N6.1: U7.20 (HVOUT30); also elsewhere on the board
N6.2: U7.19 (HVOUT29); also elsewhere on the board
N6.3: U7.18 (HVOUT28); also elsewhere on the board
N6.4: U7.17 (HVOUT27); also elsewhere on the board
N6.5: U7.16 (HVOUT26); also elsewhere on the board
N6.6: U7.15 (HVOUT25); also elsewhere on the board
N6.7: U7.14 (HVOUT24); also elsewhere on the board
N6.8: U7.13 (HVOUT23); also elsewhere on the board
N6.9: U7.12 (HVOUT22); also elsewhere on the board
unnamed: D6.2 (A), IC1.1 (SW), L5.2
unnamed: IC1.4 (EN), R36.2
unnamed: C36.2, IC1.3 (FB), R33.2, R35.1
SR_CLK_3V3: U5.6 (B); also elsewhere on the board
SR_DATA_IN_3V3: U5.3 (A); also elsewhere on the board
SR_OE_3V3: U5.14 (D); also elsewhere on the board
SR_STR_3V3: U5.10 (C); also elsewhere on the board

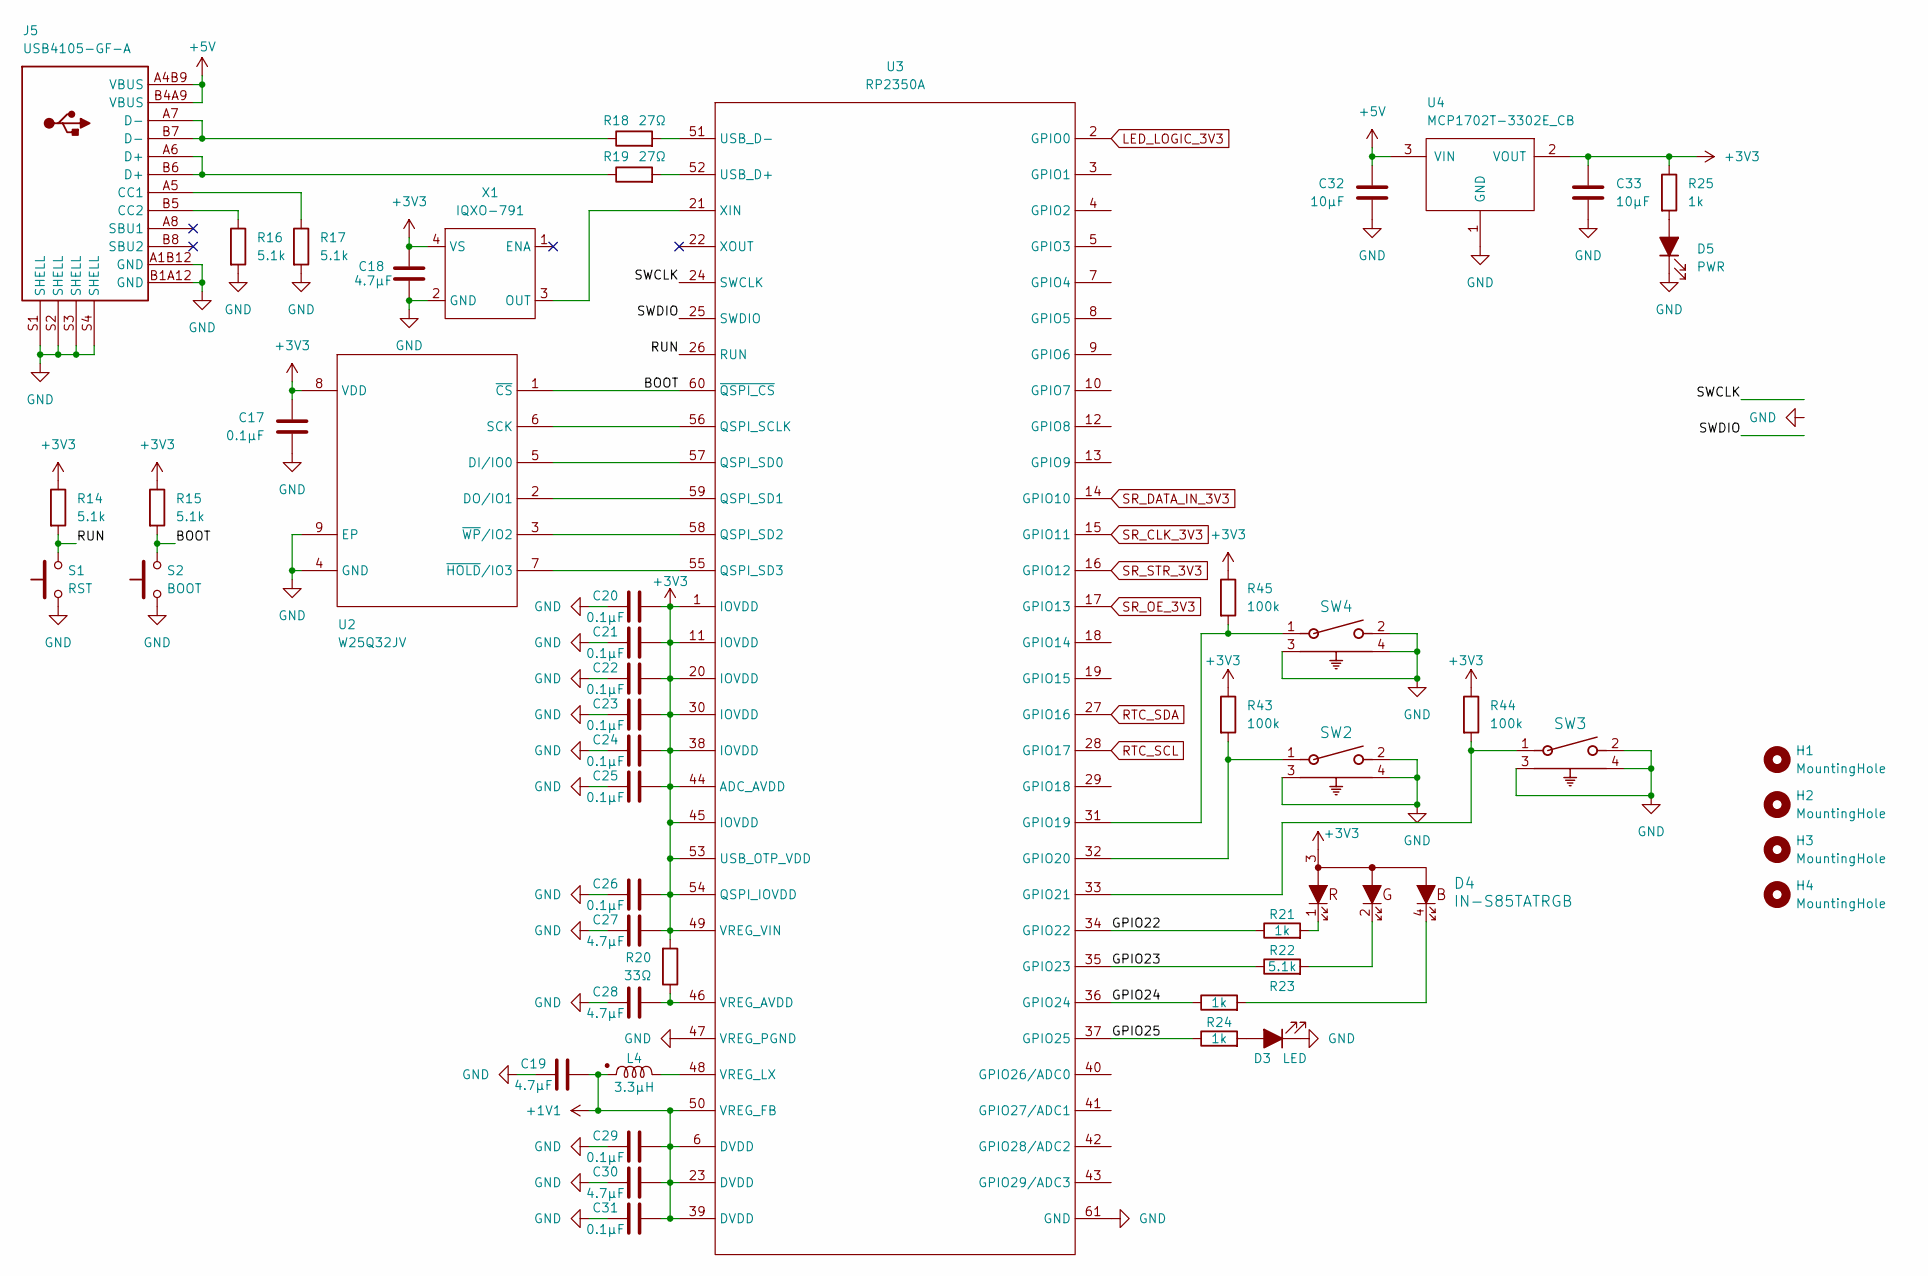
[picture p45: schematic microcontroller.kicad_sch]

Parts:
C17, C20, C21, C22, C23, C24, C25, C26, C29, C31: 0.1µF; C_0603_1608Metric; DigikeyPN 1276-1033-1-ND
C18, C19, C27, C28, C30: 4.7µF; C_0603_1608Metric; DigikeyPN 490-GRM188Z71C475KE21DCT-ND
C32, C33: 10µF; C_0603_1608Metric; DigikeyPN 490-18214-1-ND
D3: LED; LED_0805_2012Metric; DigikeyPN 1497-XZCM2MOK54WA-1VFCT-ND
D4: IN-S85TATRGB; DigikeyPN 1830-1086-1-ND
D5: PWR; LED_0805_2012Metric; DigikeyPN 160-1887-1-ND
H1, H2, H3, H4: MountingHole; MountingHole_3.2mm_M3
J5: USB4105-GF-A; DigikeyPN 2073-USB4105-GF-ACT-ND
L4: 3.3µH; AOTA-B201610S3R3-101-T
R14, R15, R16, R17, R22: 5.1k; R_0603_1608Metric; DigikeyPN P5.10KHCT-ND
R18, R19: 27Ω; R_0603_1608Metric; DigikeyPN 311-27.0HRCT-ND
R20: 33Ω; R_0603_1608Metric; DigikeyPN 13-RC0603FR-0733RLCT-ND
R21, R23, R24, R25: 1k; R_0603_1608Metric; DigikeyPN 311-1.00KHRCT-ND
R43, R44, R45: 100k; R_0603_1608Metric
S1: RST; SW_SPST_B3U-1000P; DigikeyPN SW1020CT-ND
S2: BOOT; SW_SPST_B3U-1000P; DigikeyPN SW1020CT-ND
SW2, SW3, SW4: 1825027-8; SW2_1825027-C_TEC; MPN 1825027-8; DigikeyPN 450-1657-ND
U2: W25Q32JV; WSON-8-1EP_6x5mm_P1.27mm_EP3.4x4.3mm; DigikeyPN W25Q32JVZPIQ TR
U3: RP2350A; RP2350A_QFN-60_EP_7.75x7.75_Pitch0.4mm; DigikeyPN 2648-SC1509-A4CT-ND
U4: MCP1702T-3302E_CB; SOT-23-3
X1: IQXO-791

Connections:
+1V1: C19.2, C29.2, C30.2, C31.2, L4.1, U3.6 (DVDD), U3.23 (DVDD), U3.39 (DVDD), U3.50 (VREG_FB)
+3V3: C17.2, C18.2, C20.2, C21.2, C22.2, C23.2, C24.2, C25.2, C26.2, C27.2, C33.1, D4.3, R14.1, R15.1, R20.2, R25.1, R43.1, R44.1, R45.1, U2.8 (VDD), U3.1 (IOVDD), U3.11 (IOVDD), U3.20 (IOVDD), U3.30 (IOVDD), U3.38 (IOVDD), U3.44 (ADC_AVDD), U3.45 (IOVDD), U3.49 (VREG_VIN), U3.53 (USB_OTP_VDD), U3.54 (QSPI_IOVDD), U4.2 (VOUT), X1.4 (VS); also elsewhere on the board
+5V: C32.2, J5.A4B9 (VBUS), J5.B4A9 (VBUS), U4.3 (VIN); also elsewhere on the board
/microcontroller/BOOT: R15.2, S2.2, U2.1 (~CS), U3.60 (~QSPI_CS); also elsewhere on the board
/microcontroller/GPIO22: R21.1, U3.34 (GPIO22)
/microcontroller/GPIO23: R22.1, U3.35 (GPIO23)
/microcontroller/GPIO24: R23.1, U3.36 (GPIO24)
/microcontroller/GPIO25: R24.1, U3.37 (GPIO25)
/microcontroller/RUN: R14.2, S1.2, U3.26 (RUN); also elsewhere on the board
/microcontroller/SWCLK: U3.24 (SWCLK)
/microcontroller/SWDIO: U3.25 (SWDIO)
LED_LOGIC_3V3: U3.2 (GPIO0); also elsewhere on the board
unnamed: D3.2 (A), R24.2
unnamed: D4.1, R21.2
unnamed: D4.2, R22.2
unnamed: D4.4, R23.2
unnamed: D5.2 (A), R25.2
unnamed: J5.A5 (CC1), R17.1
unnamed: J5.B5 (CC2), R16.1
unnamed: J5.A6 (D+), J5.B6 (D+), R19.1
unnamed: J5.A7 (D-), J5.B7 (D-), R18.1
unnamed: U2.5 (DI/IO0), U3.57 (QSPI_SD0)
unnamed: U2.2 (DO/IO1), U3.59 (QSPI_SD1)
unnamed: U2.6 (SCK), U3.56 (QSPI_SCLK)
unnamed: U2.7 (~HOLD/IO3), U3.55 (QSPI_SD3)
unnamed: U2.3 (~WP/IO2), U3.58 (QSPI_SD2)
unnamed 121: R45.2, SW4.1, U3.31 (GPIO19); also elsewhere on the board
unnamed 122: R43.2, SW2.1, U3.32 (GPIO20); also elsewhere on the board
unnamed 123: R44.2, SW3.1, U3.33 (GPIO21); also elsewhere on the board
unnamed: R19.2, U3.52 (USB_D+)
unnamed: R18.2, U3.51 (USB_D-)
unnamed: C28.2, R20.1, U3.46 (VREG_AVDD)
unnamed: L4.2, U3.48 (VREG_LX)
unnamed: U3.21 (XIN), X1.3 (OUT)
RTC_SCL: U3.28 (GPIO17); also elsewhere on the board
RTC_SDA: U3.27 (GPIO16); also elsewhere on the board
SR_CLK_3V3: U3.15 (GPIO11); also elsewhere on the board
SR_DATA_IN_3V3: U3.14 (GPIO10); also elsewhere on the board
SR_OE_3V3: U3.17 (GPIO13); also elsewhere on the board
SR_STR_3V3: U3.16 (GPIO12); also elsewhere on the board

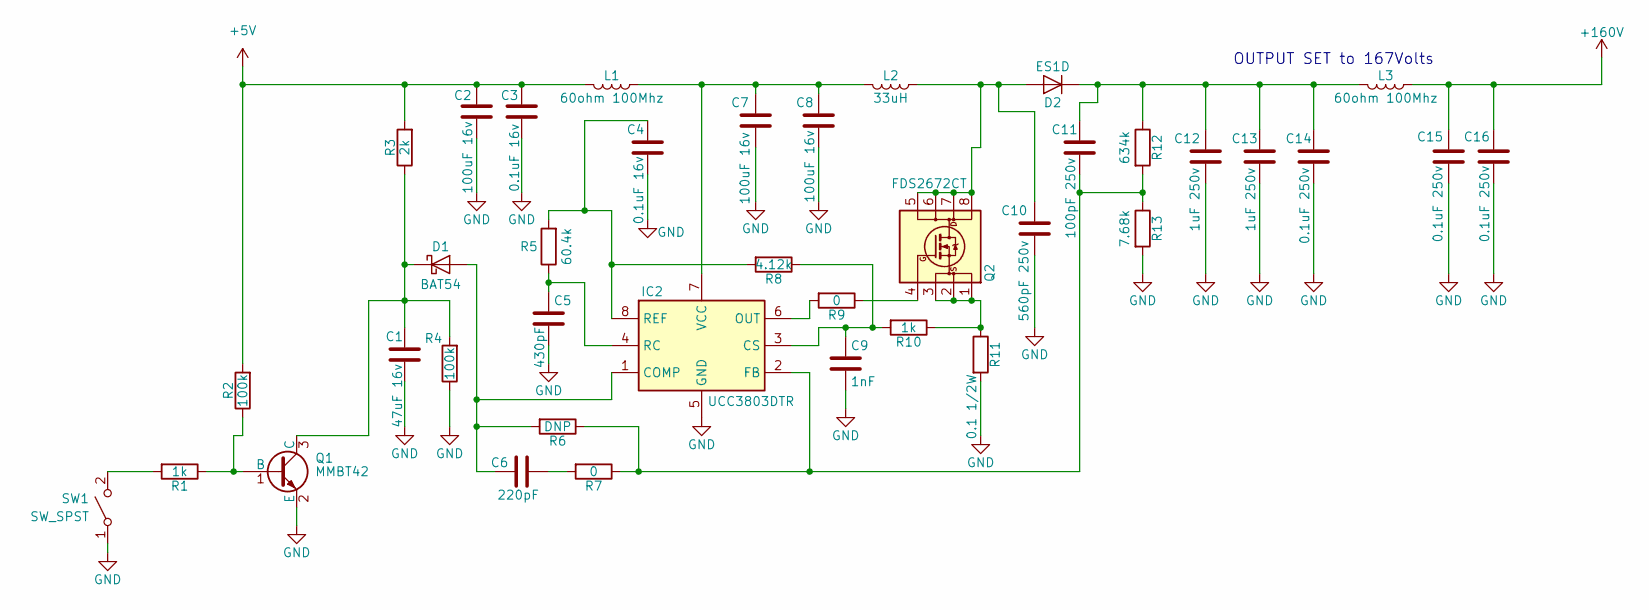
[picture p46: schematic power_supply.kicad_sch]

Parts:
C1: 47uF 16v; C_1206_3216Metric_Pad1.33x1.80mm_HandSolder; MPN C3216X5R1C476M160AB; DigikeyPN 445-6003-1-ND
C2, C7, C8: 100uF 16v; C_1210_3225Metric_Pad1.33x2.70mm_HandSolder; MPN EMK325ABJ107MM-P; DigikeyPN 587-5426-1-ND
C3, C4: 0.1uF 16v; C_0603_1608Metric; MPN C0603C104K4RACTU; DigikeyPN 399-C0603C104K4RACTUCT-ND
C5: 430pF; C_0805_2012Metric_Pad1.18x1.45mm_HandSolder; MPN CC0805JRNPO9BN431; DigikeyPN 311-4238-1-ND
C6: 220pF; C_0805_2012Metric_Pad1.18x1.45mm_HandSolder; MPN 885012207029; DigikeyPN 732-8029-1-ND
C9: 1nF; C_0805_2012Metric_Pad1.18x1.45mm_HandSolder; MPN C0805C102J5GACTU; DigikeyPN 399-C0805C102J5GACTUCT-ND
C10: 560pF 250v; C_0603_1608Metric_Pad1.08x0.95mm_HandSolder; MPN C0603C561JAGAC7867; DigikeyPN 399-C0603C561JAGACTUCT-ND
C11: 100pF 250v; C_0805_2012Metric_Pad1.18x1.45mm_HandSolder; MPN GRM21A5C2E101JW01D; DigikeyPN 490-5542-1-ND
C12, C13: 1uF 250v; C_2220_5750Metric_Pad1.97x5.40mm_HandSolder; MPN GRM55DR72E105KW01L; DigikeyPN 490-3550-1-ND
C14, C15, C16: 0.1uF 250v; C_0805_2012Metric_Pad1.18x1.45mm_HandSolder; MPN CGA4J3X7T2E104M125AE; DigikeyPN 445-7965-1-ND
D1: BAT54; D_SOD-323_HandSoldering; MPN BAT54HT1G; DigikeyPN BAT54HT1GOSCT-ND
D2: ES1D; D_SMA_Handsoldering; MPN ES1D; DigikeyPN ES1DFSCT-ND
IC2: UCC3803DTR; SOIC127P600X175-8N; MPN UCC3803DTR; DigikeyPN 296-38327-1-ND
L1: 60ohm 100Mhz; L_0805_2012Metric; MPN MH2029-600Y; DigikeyPN MH2029-600YCT-ND
L2: 33uH; WE-PD_1210; MPN 7447709330; DigikeyPN 732-1244-1-ND
L3: 60ohm 100Mhz; L_0805_2012Metric; MPN MH2029-600Y; DigiKeyPN MH2029-600YCT-ND
Q1: MMBT42; SOT-23; MPN MMBTA42-TP; DigikeyPN MMBTA42TPMSCT-ND
Q2: FDS2672CT; SOIC-8_3.9x4.9mm_P1.27mm; MPN FDS2672CT-ND
R1: 1k; R_0603_1608Metric; MPN RC0603FR-071KL; DigikeyPN 311-1.00KHRCT-ND
R2, R4: 100k; R_0805_2012Metric_Pad1.20x1.40mm_HandSolder; MPN CRCW0805100KFKEA; DigikeyPN 541-100KCCT-ND
R3: 2k; R_0805_2012Metric_Pad1.20x1.40mm_HandSolder; MPN CRCW08052K00FKEA; DigikeyPN 541-2.00KCCT-ND
R5: 60.4k; R_0805_2012Metric_Pad1.20x1.40mm_HandSolder; MPN CRCW080560K4FKEA; DigikeyPN 541-60.4KCCT-ND
R6: DNP; R_0805_2012Metric_Pad1.20x1.40mm_HandSolder
R7, R9: 0; R_0603_1608Metric; MPN RC0603JR-070RL; DigikeyPN 311-0.0GRCT-ND
R8: 4.12k; R_0805_2012Metric_Pad1.20x1.40mm_HandSolder; MPN CRCW08054K12FKEA; DigikeyPN 541-4.12KCCT-ND
R10: 1k; R_0805_2012Metric_Pad1.20x1.40mm_HandSolder; MPN ERJ-P06J102V; DigikeyPN P1.0KADCT-ND
R11: 0.1 1/2W; R_0805_2012Metric_Pad1.20x1.40mm_HandSolder; MPN ERJ-6DSFR10V; DigikeyPN P19308CT-ND
R12: 634k; R_0805_2012Metric_Pad1.20x1.40mm_HandSolder; MPN CRCW0805634KFKEA; DigikeyPN 541-634KCCT-ND
R13: 7.68k; R_0805_2012Metric_Pad1.20x1.40mm_HandSolder; MPN RC1206FR-077K68L; DigikeyPN 311-7.68KFRCT-ND
SW1: SW_SPST; PinHeader_1x02_P2.54mm_Vertical

Connections:
+5V: C2.1, C3.1, L1.2, R2.2, R3.2; also elsewhere on the board
+160V: C15.1, C16.1, L3.1; also elsewhere on the board
unnamed: C1.1, D1.1 (K), Q1.3 (C), R3.1, R4.2
unnamed: C10.1, D2.2 (A), L2.1, Q2.5 (D), Q2.6 (D), Q2.7 (D), Q2.8 (D)
unnamed: C11.1, C12.1, C13.1, C14.1, D2.1 (K), L3.2, R12.1
unnamed: C9.1, IC2.3 (CS), R8.1, R10.2
unnamed: C11.2, IC2.2 (FB), R6.1, R7.1, R12.2, R13.1
unnamed: IC2.6 (OUT), R9.2
unnamed: C5.1, IC2.4 (RC), R5.1
unnamed: C7.1, C8.1, IC2.7 (VCC), L1.1, L2.2
unnamed: Q1.1 (B), R1.1, R2.1
unnamed: Q2.4 (G), R9.1
unnamed: Q2.1 (S), Q2.2 (S), Q2.3 (S), R10.1, R11.1
unnamed: R1.2, SW1.2 (B)

Notes on the sheet:
OUTPUT SET to 167Volts

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
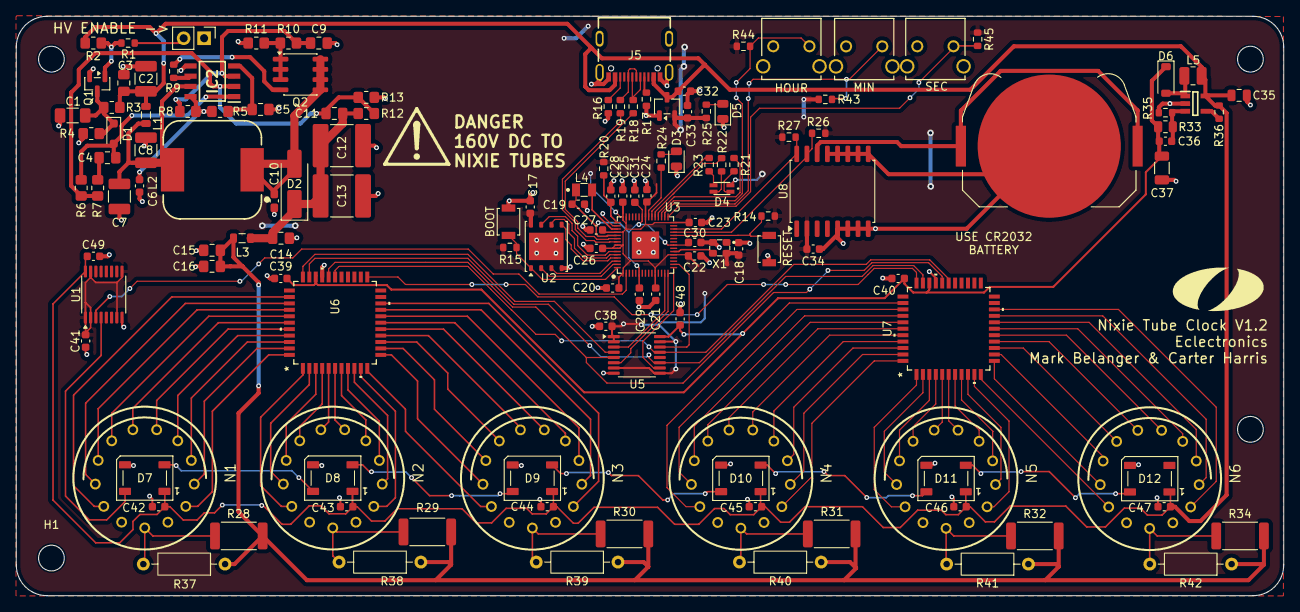
[picture p47: board nixie-tube-clock.kicad_pcb from above]

Board: 2 copper layers, 157.5 x 72.0 mm, 144 parts (0 on the bottom side), 137 nets.

Other parts of the board:
BOOT: BOOT; SW_SPST_B3U-1000P
HOUR: 1825027-8; SW2_1825027-C_TEC
MIN: 1825027-8; SW2_1825027-C_TEC
OlinLogoLg: G***; OlinLogoLg
RESET: RST; SW_SPST_B3U-1000P
SEC: 1825027-8; SW2_1825027-C_TEC
svg2mod: G***; OlinLogoHuge

Their connections:
/microcontroller/BOOT: BOOT.2; also elsewhere on the board
/microcontroller/RUN: RESET.2; also elsewhere on the board
unnamed 121: SEC.1; also elsewhere on the board
unnamed 122: MIN.1; also elsewhere on the board
unnamed 123: HOUR.1; also elsewhere on the board
