mbelanger0/nixie-tube-clock/(commit log)

2026-03-12 Add starter schematics and footprint for clock
    [1725656.stp, 219-3M.STEP, 3382g-001-xxx.stp, 5442565.stp, ABM10-27.000MHZ-E20-T.step, ABM10.STP, ABS06-107.STP, AOTA-B201610S3R3-101-T.stp]
2026-03-23 Create symbol & footprint libraries
    [QFP44_10x10MC_MCH.step, nixie_tubes_driver.kicad_sch]
2026-03-23 Add KiCad gitignore
2026-03-23 Add nixie tube symbols & footprints
2026-03-24 Add current limiting resistors and net labels to nixie tubes
    [nixie_tubes.kicad_sch, nixie_tubes_driver.kicad_sch]
2026-03-24 Fix nixie tube net label
    [nixie_tubes.kicad_sch]
2026-03-26 Add nixie tube net labels and dc/dc converter
    [microcontroller.kicad_sch, nixie_tubes_driver.kicad_sch, real_time_clock.kicad_sch]
2026-03-26 Add more net labels to driver
    [nixie_tubes_driver.kicad_sch]
2026-03-26 Add boost converter to library
    [TPS61041DBVR.stp]
2026-03-26 Add 12V boost converter
    [microcontroller.kicad_sch, nixie_tubes_driver.kicad_sch]
2026-03-27 Add data connections between driver and rp2350
    [microcontroller.kicad_sch, nixie_tubes_driver.kicad_sch]
2026-04-02 Update power supply layout and add associated components
    [UCC3803DTR.stp, nixie_tubes.kicad_sch, nixie_tubes_driver.kicad_sch, power_supply.kicad_sch, real_time_clock.kicad_sch]
2026-04-02 Add backlight LEDs
    [microcontroller.kicad_sch, nixie_tubes.kicad_sch, nixie_tubes_driver.kicad_sch]
2026-04-02 Add power supply footprints; begin layout
    [nixie-tube-clock.kicad_pcb, nixie_tubes.kicad_sch, power_supply.kicad_sch]
2026-04-03 Add global labels for nets spanning several sheets
    [microcontroller.kicad_sch, nixie-tube-clock.kicad_pcb, nixie_tubes.kicad_sch, nixie_tubes_driver.kicad_sch, real_time_clock.kicad_sch]
2026-04-03 Modify nixie tube nets for easier layout
    [nixie-tube-clock.kicad_pcb, nixie_tubes_driver.kicad_sch]
2026-04-05 Begin positioning and grouping components
    Add bypass caps to level shifters Vdd
    Rearrange pins on shift register
    [microcontroller.kicad_sch, nixie-tube-clock.kicad_pcb, nixie_tubes_driver.kicad_sch]
2026-04-06 add power supply layout
    [Download_WE-PD_1210_STP+%28rev1%29.stp, nixie-tube-clock.kicad_pcb]
2026-04-06 Add DigiKey part numbers to components
    [microcontroller.kicad_sch, nixie_tubes.kicad_sch, nixie_tubes_driver.kicad_sch, power_supply.kicad_sch, real_time_clock.kicad_sch]
2026-04-07 Begin layout of microcontroller components
    [microcontroller.kicad_sch, nixie-tube-clock.kicad_pcb]
2026-04-09 Update inductor footprint
    [power_supply.kicad_sch]
2026-04-09 Fix 3V3/+3V3 nets; update pinouts for easier routing
    [microcontroller.kicad_sch, nixie_tubes_driver.kicad_sch, power_supply.kicad_sch]
2026-04-09 Complete layout first pass
    [nixie-tube-clock.kicad_pcb]
2026-04-13 Add small schematic/layout changes
    [nixie-tube-clock.kicad_pcb]
2026-04-13 Add time set buttons
    [c-1825027-8-g-3d.stp, microcontroller.kicad_sch, nixie-tube-clock.kicad_pcb]
2026-04-13 Fix +160V clearance issues
    [nixie-tube-clock.kicad_pcb]
2026-04-13 BOM simplification of redundant components
    [microcontroller.kicad_sch, nixie_tubes.kicad_sch, nixie_tubes_driver.kicad_sch, power_supply.kicad_sch, real_time_clock.kicad_sch]
2026-04-13 BOM project file
2026-04-13 Fix silkscreen overlap; add logo
    [nixie-tube-clock.kicad_pcb]
2026-04-16 Remove extra untitled scheamtic
    [untitled.kicad_sch]
2026-04-16 Misc final project updates
    [nixie-tube-clock.kicad_pcb]
2026-04-16 Add BOM
    [nixie-tube-clock_bom.csv]
2026-04-16 Add production gerbers
    [nixie-tube-clock-B_Cu.gbr, nixie-tube-clock-B_Mask.gbr, nixie-tube-clock-B_Paste.gbr, nixie-tube-clock-B_Silkscreen.gbr, nixie-tube-clock-Edge_Cuts.gbr, nixie-tube-clock-F_Cu.gbr, nixie-tube-clock-F_Mask.gbr, nixie-tube-clock-F_Paste.gbr]
2026-04-23 Fix misplacement of spi tx and clk pins
    [microcontroller.kicad_sch]
2026-04-30 Add BOM CSV
    [nixie-tube-clock_bom.csv]
